gf5ckszr2d-cell/tesis-star-tracker/Inventor/Mecanismo_3GDL/Alineacion_R1_20261113/Captura_real_Inventor_Gimbal_R1.jpg

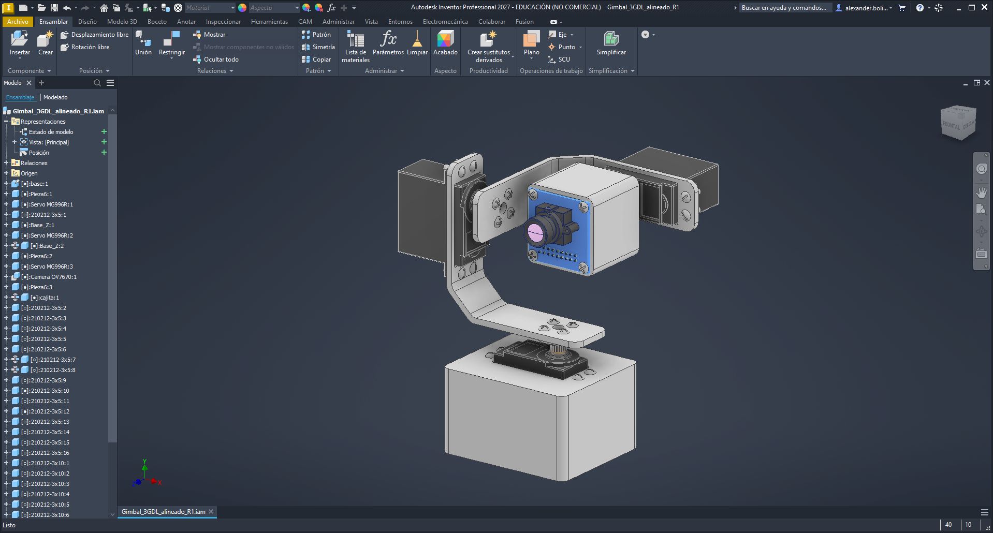
Inventor/Mecanismo_3GDL/Alineacion_R1_20261113/Captura_real_Inventor_Gimbal_R1.jpg
