gf5ckszr2d-cell/tesis-star-tracker/Inventor/Mecanismo_3GDL/Alineacion_R1_20261113/Gimbal_R1_ejes_anotados_generada.png

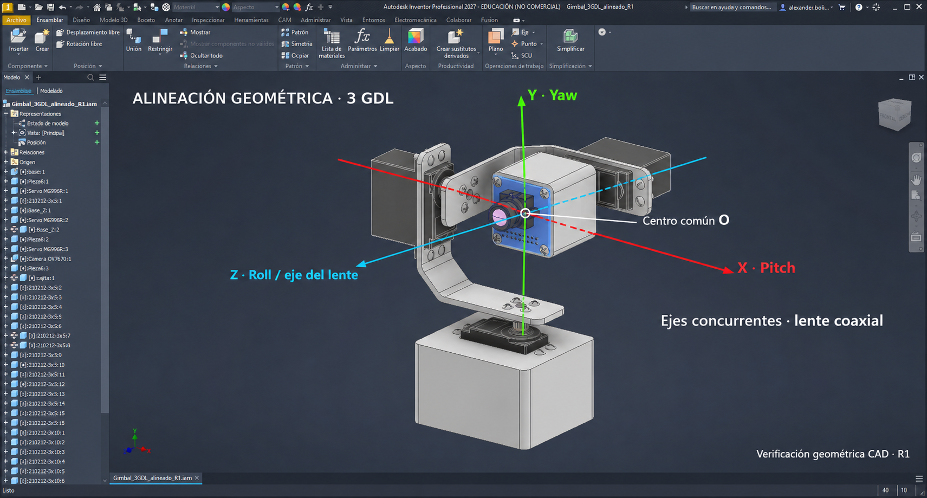
Inventor/Mecanismo_3GDL/Alineacion_R1_20261113/Gimbal_R1_ejes_anotados_generada.png
