gf5ckszr2d-cell/tesis-star-tracker/Inventor/Mecanismo_3GDL/Auditoria_integral_20261113/Choque_carcasa_base_yaw_m60_pitch_m60.jpg

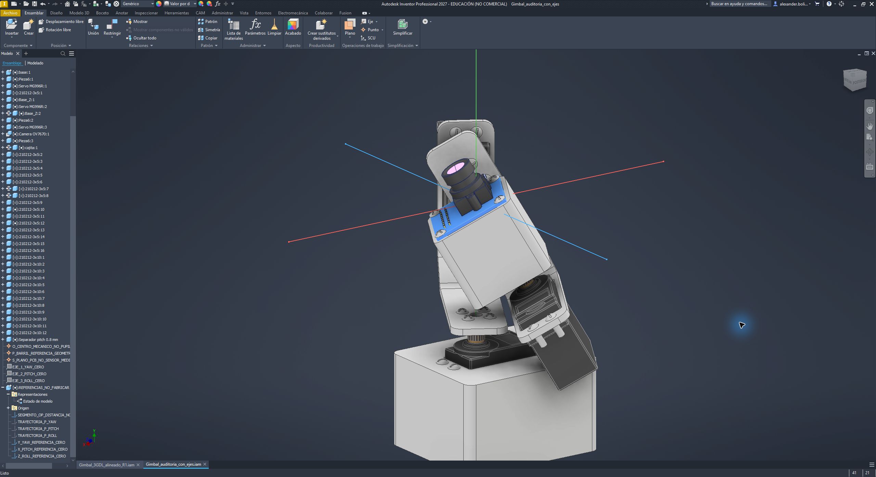
Inventor/Mecanismo_3GDL/Auditoria_integral_20261113/Choque_carcasa_base_yaw_m60_pitch_m60.jpg
