gf5ckszr2d-cell/tesis-star-tracker/Inventor/Mecanismo_3GDL/Auditoria_integral_20261113/Ejes_reales_y_referencias_Inventor.jpg

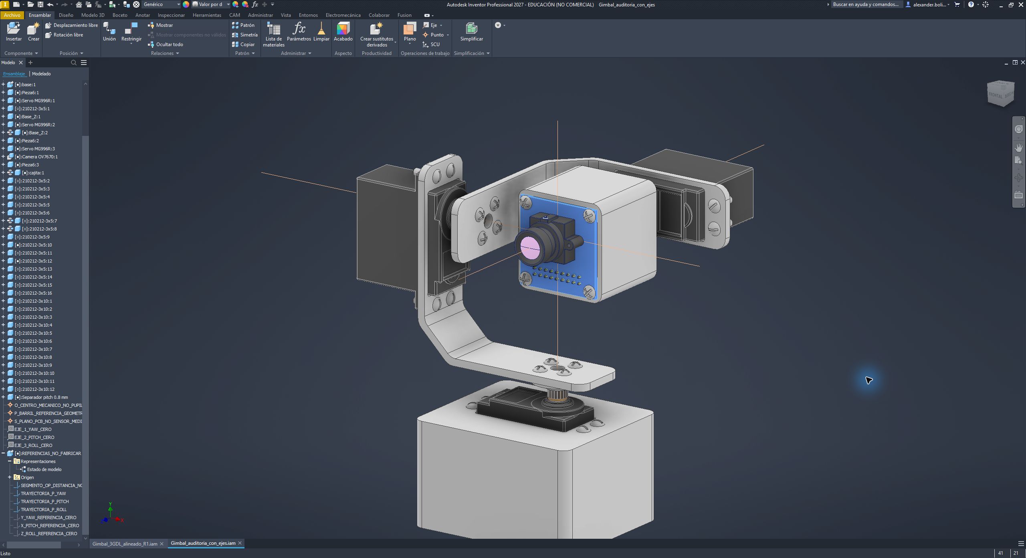
Inventor/Mecanismo_3GDL/Auditoria_integral_20261113/Ejes_reales_y_referencias_Inventor.jpg
