gf5ckszr2d-cell/tesis-star-tracker/Inventor/Mecanismo_3GDL/Auditoria_integral_20261113/Referencia_ejes_usuario.png

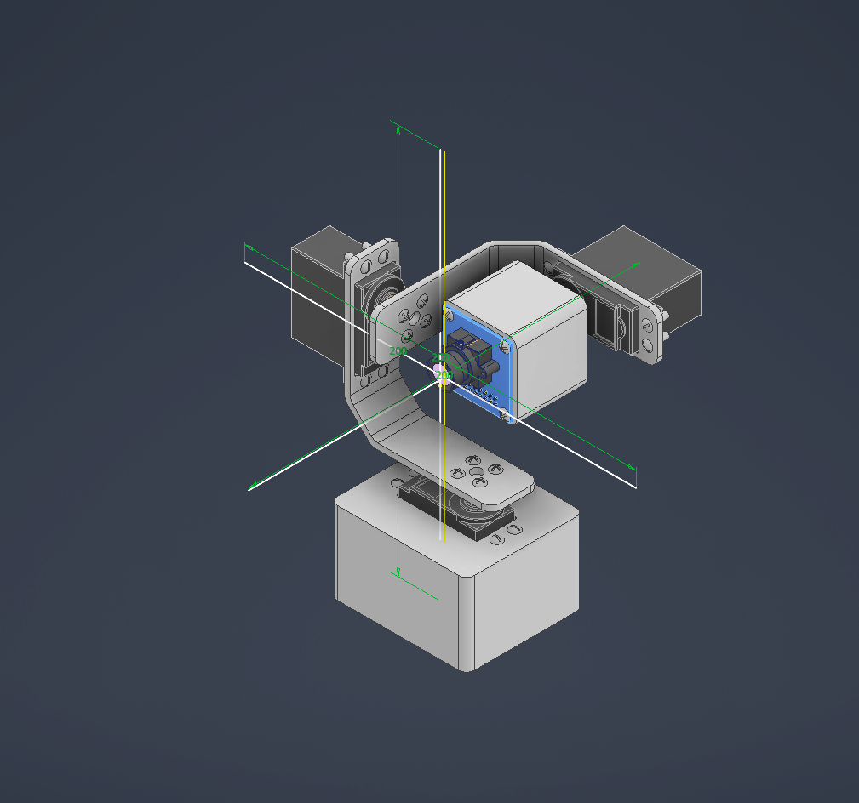
Inventor/Mecanismo_3GDL/Auditoria_integral_20261113/Referencia_ejes_usuario.png
