gf5ckszr2d-cell/tesis-star-tracker/Inventor/Mecanismo_3GDL/Revision_20261113/plano-2.png

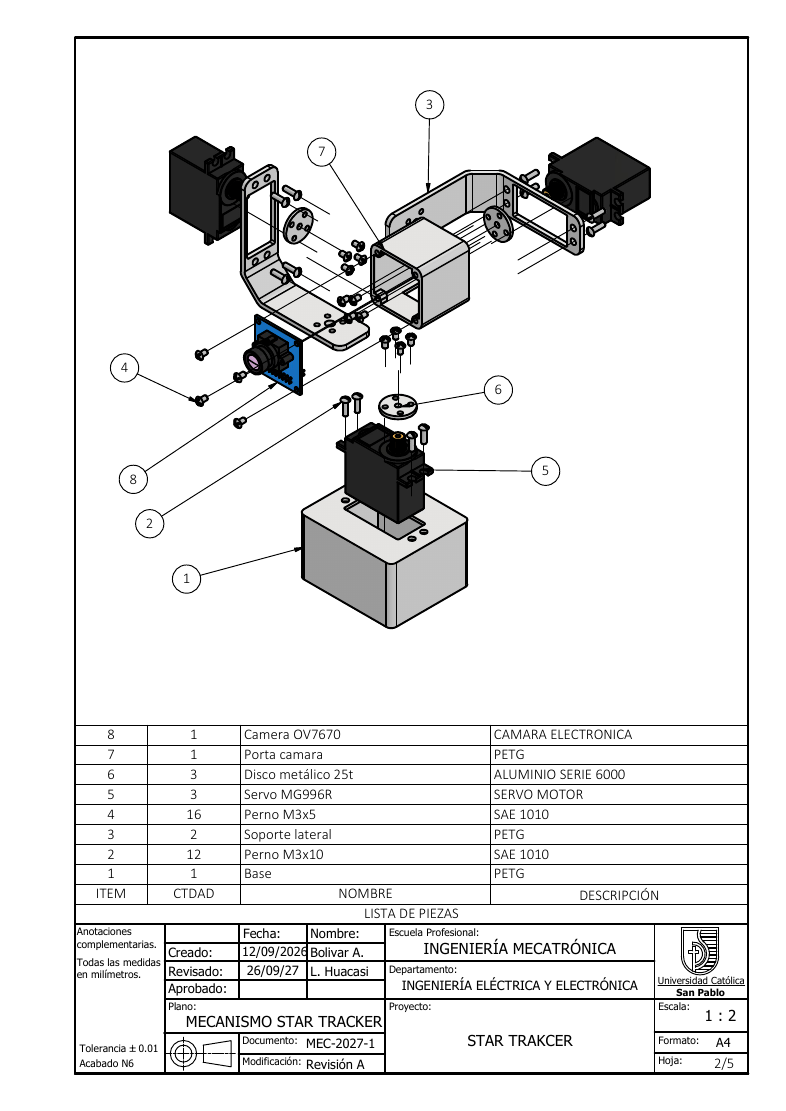
Inventor/Mecanismo_3GDL/Revision_20261113/plano-2.png
