gf5ckszr2d-cell/tesis-star-tracker/recepción de frame/capturas/frame_y.png

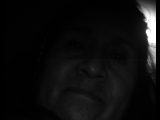
recepción de frame/capturas/frame_y.png
