gf5ckszr2d-cell/tesis-star-tracker/Inventor/Mecanismo_3GDL/Auditoria_integral_20261113/Control/interferencias_movimiento.csv

pose | component_a | component_b | volume_mm3 | class
zero | Servo MG996R:3 | Pieza6:3 | 120.21451917 | servo_head_model_pending
zero | Pieza6:2 | Servo MG996R:2 | 50.3520624212 | servo_head_model_pending
zero | Servo MG996R:1 | Pieza6:1 | 50.3520624212 | servo_head_model_pending
yaw_-60 | Servo MG996R:3 | Pieza6:3 | 120.21451917 | servo_head_model_pending
yaw_-60 | Pieza6:2 | Servo MG996R:2 | 50.3520624211 | servo_head_model_pending
yaw_-60 | Servo MG996R:1 | Pieza6:1 | 50.3520624212 | servo_head_model_pending
yaw_-30 | Servo MG996R:3 | Pieza6:3 | 120.21451917 | servo_head_model_pending
yaw_-30 | Pieza6:2 | Servo MG996R:2 | 50.3520624211 | servo_head_model_pending
yaw_-30 | Servo MG996R:1 | Pieza6:1 | 50.3520624212 | servo_head_model_pending
yaw_-15 | Servo MG996R:3 | Pieza6:3 | 120.21451917 | servo_head_model_pending
yaw_-15 | Pieza6:2 | Servo MG996R:2 | 50.3520624211 | servo_head_model_pending
yaw_-15 | Servo MG996R:1 | Pieza6:1 | 50.3520624212 | servo_head_model_pending
yaw_15 | Servo MG996R:3 | Pieza6:3 | 120.21451917 | servo_head_model_pending
yaw_15 | Pieza6:2 | Servo MG996R:2 | 50.3520624211 | servo_head_model_pending
yaw_15 | Servo MG996R:1 | Pieza6:1 | 50.3520624212 | servo_head_model_pending
yaw_30 | Servo MG996R:3 | Pieza6:3 | 120.21451917 | servo_head_model_pending
yaw_30 | Pieza6:2 | Servo MG996R:2 | 50.3520624211 | servo_head_model_pending
yaw_30 | Servo MG996R:1 | Pieza6:1 | 50.3520624212 | servo_head_model_pending
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
combined_mixed | Servo MG996R:3 | Pieza6:3 | 120.21451918 | servo_head_model_pending
combined_mixed | Pieza6:2 | Servo MG996R:2 | 50.3520624154 | servo_head_model_pending
combined_mixed | Servo MG996R:1 | Pieza6:1 | 50.3520624212 | servo_head_model_pending
