gf5ckszr2d-cell/tesis-star-tracker/(list of files, cad)

Other CAD files:
Inventor/Mecanismo_3GDL/Alineacion_R1_20261113/CAD/Camera OV7670.ipt
Inventor/Mecanismo_3GDL/Alineacion_R1_20261113/CAD/Pieza6.ipt
Inventor/Mecanismo_3GDL/Alineacion_R1_20261113/CAD/Separador_pitch_0p8_R1.ipt
Inventor/Mecanismo_3GDL/Alineacion_R1_20261113/CAD/cajita.ipt
Inventor/Mecanismo_3GDL/Auditoria_integral_20261113/CAD/210212-3x5.ipt
Inventor/Mecanismo_3GDL/Auditoria_integral_20261113/CAD/EjeY.ipt
Inventor/Mecanismo_3GDL/Auditoria_integral_20261113/CAD/Gimbal_auditoria_con_ejes.iam
Inventor/Mecanismo_3GDL/Auditoria_integral_20261113/CAD/Gimbal_barrido_125.iam
Inventor/Mecanismo_3GDL/Auditoria_integral_20261113/CAD/Referencias_cinematicas.ipt
Inventor/Mecanismo_3GDL/Auditoria_integral_20261113/CAD/Servo MG996R.ipt
Inventor/Mecanismo_3GDL/Auditoria_integral_20261113/CAD/base.ipt
Inventor/Mecanismo_3GDL/CAD_portable/210212-3x10.ipt
Inventor/Mecanismo_3GDL/CAD_portable/Servo MG996R.ipt
Inventor/Mecanismo_3GDL/CAD_portable/cajita.ipt
Inventor/Mecanismo_3GDL/Original/Base_Z.ipt
Inventor/Mecanismo_3GDL/Original/Ejez.ipt
Inventor/Mecanismo_3GDL/Original/OldVersions/Base_Z.0002.ipt
Inventor/Mecanismo_3GDL/Original/OldVersions/Ejez.0003.ipt
Inventor/Mecanismo_3GDL/Original/OldVersions/Pieza6.0002.ipt
Inventor/Mecanismo_3GDL/Original/OldVersions/base.0002.ipt
Inventor/Mecanismo_3GDL/Original/OldVersions/cajita.0001.ipt
Inventor/Mecanismo_3GDL/Original/OldVersions/mecanismo compoleto.0001.ipn
Inventor/Mecanismo_3GDL/Original/OldVersions/mecanismo compoleto.0004.iam
Inventor/Mecanismo_3GDL/Original/mecanismo compoleto.iam
Inventor/Mecanismo_3GDL/Original/mecanismo compoleto.ipn
