gf5ckszr2d-cell/tesis-star-tracker/Inventor/Mecanismo_3GDL/Auditoria_integral_20261113/Control/ejes_moviles_verificados.txt

MOVED=False OCC=Servo MG996R:1 DIR=-2.34942862846E-32,-1,1.73472347598E-16 CENTER_MISS_MM=2.0661563443E-11
MOVED=False OCC=Servo MG996R:2 DIR=-1,1.96638228954E-15,-4.25585492773E-16 CENTER_MISS_MM=1.48852415319E-11
MOVED=False OCC=Servo MG996R:3 DIR=1.09786546787E-15,-1.37761517962E-15,-1 CENTER_MISS_MM=1.44500495542E-11
MOVED=True OCC=Servo MG996R:1 DIR=-3.31239360065E-32,-1,1.73472347598E-16 CENTER_MISS_MM=2.06607778479E-11
MOVED=True OCC=Servo MG996R:2 DIR=-0.939692620786,2.10701379323E-15,-0.342020143326 CENTER_MISS_MM=9.0209651284E-12
MOVED=True OCC=Servo MG996R:3 DIR=0.296198132726,0.5,-0.813797681349 CENTER_MISS_MM=1.91322838463E-11
LIVE_AXIS_BINDING_PASS=true
