gf5ckszr2d-cell/tesis-star-tracker/pruebas_arty_z7/captura_ov7670_qvga/pc/requirements-banco-verificadas.txt

pyserial==3.5
Pillow==13.0.0
numpy==2.3.5
