gf5ckszr2d-cell/tesis-star-tracker/pruebas_arty_z7/captura_ov7670_qvga/output/LAP_20261110/DoE_final_plan_tesis_completa_16_v3.pptx

Star Tracker

Planificación del DoE
y del LAP

D1–D5, integración en FPGA
y entrega final de tesis
1–11 DoE 12–16 LAP

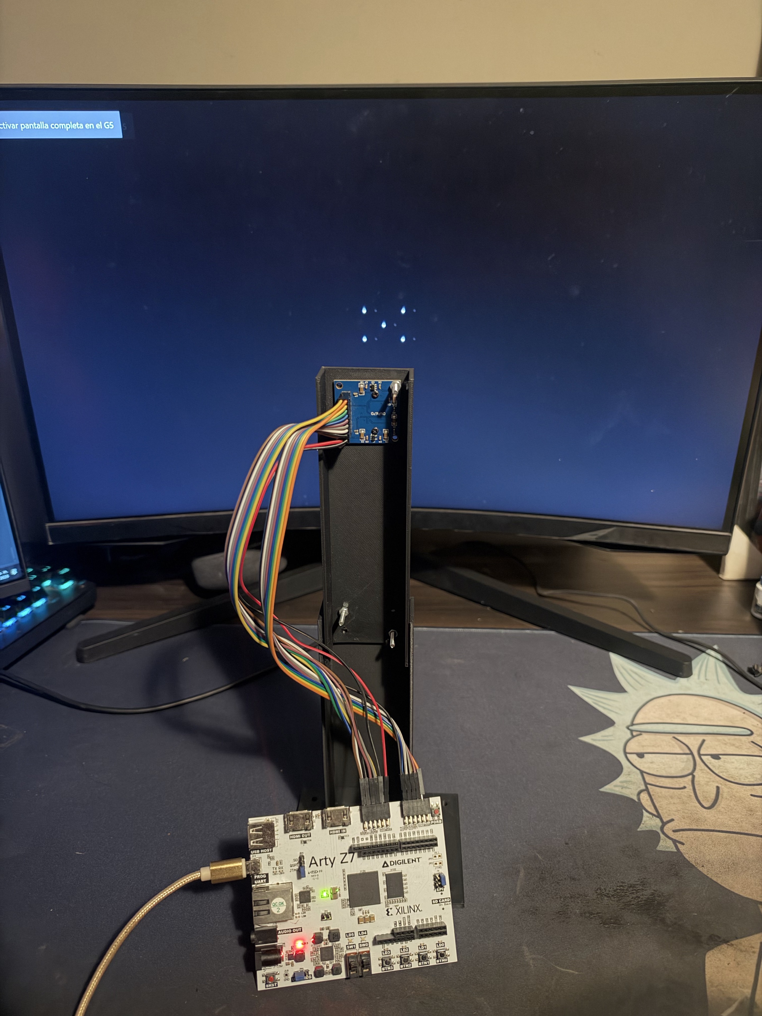
[picture p13: figure]

Alexander Bolívar Huachaca · Plan de tesis · 10 de noviembre de 2026

01

Notes: Esta exposición planifica toda la tesis. El DoE definirá factores, niveles, repeticiones y análisis desde la captura hasta la identificación y la actitud. El LAP establecerá cómo aceptar el sistema completo. La planificación también incluye integración en FPGA, informes y entrega final. Las cantidades son propuestas de ensayo y los límites son metas por comprobar.

Fuentes y alcance:
Alexander Bolívar Huachaca · Plan de tesis · 10 de noviembre de 2026

## Slide 2

DoE · Objetivo y alcance de toda la tesis

Etapa | Qué se investigará | Salida prevista
D1 | Exposición y ganancia | Perfil de captura candidato
D2 | Tamaño y posición de fuente | Centroide y referencia geométrica
D3 | Separación y ruido | Dominio de fuentes distinguibles
D4 | Catálogo e interferencias | Identificadores HIP y rechazos
D5 | Orientación y tiempo | Cuaternión, validez y latencia

Integración prevista: cadena operativa en VHDL/FPGA, LAP y memoria final.
Banco: Arty Z7 + OV7670, YUV422, luminancia QVGA 320 × 240.

Planificación del DoE de tesis. Niveles y cantidades propuestos antes de ejecutar.

02

Notes: El objetivo será caracterizar y ajustar un sistema que capture estrellas, extraiga sus centroides, las identifique en catálogo y estime actitud con una salida válida. D1 a D3 estudiarán imagen, posición y separación. D4 estudiará identificación y D5 actitud y tiempo. Después se integrará la cadena operativa en FPGA y se comprobará con el LAP. El PC preparará escenas y actuará como referencia independiente y registro.

Fuentes y alcance:
Planificación del DoE de tesis. Niveles y cantidades propuestos antes de ejecutar.

## Slide 3

DoE · Flujo y dependencias

D1 · Captura

Perfil de exposición
y ganancia

D2 · Centroide

Referencia geométrica
y tamaño útil

D3 · Separación

Fuentes distinguibles
en campos con ruido

LAP · Sistema

Datos reservados
y criterios congelados

D5 · Actitud

Cuaternión válido
y tiempo de respuesta

D4 · Identificación

Asociaciones HIP
contrastadas con catálogo

Cada etapa entregará entradas verificables a la siguiente. El LAP sustentará las conclusiones de tesis.

Planificación del DoE de tesis. Niveles y cantidades propuestos antes de ejecutar.

03

Notes: D1 fijará una imagen útil para medir en D2. D2 fijará la referencia y el tamaño útil para estudiar separación en D3. D3 definirá qué campos pueden entrar al identificador de D4. D4 entregará correspondencias verificables para estimar actitud en D5. El LAP comprobará la configuración integrada con datos reservados. Un fallo de imagen devolverá a D1, de geometría o tamaño a D2, de separación a D3, de identificación a D4 y de estimación a D5.

Fuentes y alcance:
Planificación del DoE de tesis. Niveles y cantidades propuestos antes de ejecutar.

## Slide 4

DoE · Variables, controles y referencia

Condiciones del banco

Distancia: 250 mm
Montaje, pose y foco fijos
Brillo OSD 0 y HDR desactivado
Pantalla 2560×1440, escalado registrado
Perfil D1 fijo para D2–D5
Una captura por condición y bloque

Referencia geométrica prevista

Escalado real del patrón a pantalla
Mapa pantalla–cámara con puntos
de ajuste y puntos reservados
Ángulo: θ = arctan(Δx / distancia)
Focal efectiva e intrínsecos calibrados
Distorsión e incertidumbre registradas

Centroide: error radial respecto a una referencia independiente.
Actitud: error angular respecto a q_ref con convenciones y unidades registradas.

Planificación del DoE de tesis. Niveles y cantidades propuestos antes de ejecutar.

04

Notes: Las unidades de diseño serán píxeles del generador y las medidas serán píxeles de cámara o grados, según la etapa. Se registrará el escalado real de la ventana. La geometría relacionará pantalla, cámara y catálogo. Antes de comparar centroides se obtendrá un mapa local y antes de verificar actitud se calibrarán intrínsecos y distorsión, indicando marcos, focal efectiva e incertidumbre. Las cinco repeticiones por condición se distribuirán en cinco bloques con orden aleatorio.

Fuentes y alcance:
Planificación del DoE de tesis. Niveles y cantidades propuestos antes de ejecutar.
El desplazamiento Δx se expresará en longitud física de pantalla tras verificar su paso y escalado. La calibración geométrica inicial usará nueve posiciones por tres capturas, seis posiciones para ajustar y tres reservadas. El mapa afín local no bastará por sí solo para demostrar exactitud angular del sistema. La calibración intrínseca para D5 incluirá su propio registro y verificación antes de congelar la configuración. El centroide de intensidad se definirá sobre Y menos el fondo con una política de umbral fija. Las repeticiones no equivalen a escenas independientes.

## Slide 5

D1 · Exposición y ganancia

Condición | Exposición | Ganancia | Repeticiones | Capturas
C01 | 96 | 0 | 5 | 5
C02 | 96 | 16 | 5 | 5
C03 | 192 | 0 | 5 | 5
C04 | 192 | 16 | 5 | 5
C05 | 384 | 0 | 5 | 5
C06 | 384 | 16 | 5 | 5

30 capturas. Exposición y ganancia: códigos de registro.
Respuestas: contraste, ruido y saturación.

Planificación del DoE de tesis. Niveles y cantidades propuestos antes de ejecutar.

05

Notes: D1 planificará un factorial de tres exposiciones y dos ganancias. Cada una de las seis condiciones tendrá cinco repeticiones, una por bloque. El patrón inicial será un campo fijo de cinco fuentes. Se registrarán integridad, contraste, ruido de fondo, picos y saturación. Los códigos de registro se comprobarán en la preparación y se fijarán antes de ejecutar la matriz. Se elegirá un perfil que permita medir las etapas siguientes.

Fuentes y alcance:
Planificación del DoE de tesis. Niveles y cantidades propuestos antes de ejecutar.
Códigos del sensor, no milisegundos ni decibelios. Patrón nominal inicial: cinco discos de ocho píxeles de diseño, RGB 255, sin ruido añadido. Se verificará que queden en el encuadre. Los parámetros son propuestas que se congelarán tras el piloto.

## Slide 6

D2 · Tamaño y centroide

Condición | Diámetro de diseño | Posición | Repeticiones | Capturas
C01 | 4 px | Centro | 5 | 5
C02 | 4 px | +50 px | 5 | 5
C03 | 8 px | Centro | 5 | 5
C04 | 8 px | +50 px | 5 | 5
C05 | 12 px | Centro | 5 | 5
C06 | 12 px | +50 px | 5 | 5

3 × 2 × 5 = 30 capturas. Perfil D1 fijo y referencia geométrica.

Planificación del DoE de tesis. Niveles y cantidades propuestos antes de ejecutar.

06

Notes: D2 combinará tres diámetros del patrón y dos posiciones con cinco repeticiones por condición. Se usará una fuente aislada y el perfil seleccionado en D1. Se registrarán FWHM, posición, error radial y dispersión. Las coordenadas de referencia procederán de la geometría calibrada y del escalado real. El análisis en PC caracterizará la escena y contrastará el resultado, mientras que el LAP verificará el centroide operativo de FPGA.

Fuentes y alcance:
Planificación del DoE de tesis. Niveles y cantidades propuestos antes de ejecutar.
FWHM y centroides se expresarán en píxeles de cámara, mientras que el diámetro de este factor está en píxeles de diseño. Error radial e_i = distancia entre centroide y referencia. RMS radial = raíz del promedio de e_i². Se informarán sesgo y dispersión por separado, con incertidumbre de referencia. La posición desplazada deberá seguir dentro del encuadre. Se reservarán diez capturas auxiliares para confirmar el perfil de D2.

## Slide 7

D3 · Separación y ruido

Condición | Separación de diseño | Ruido σRGB | Repeticiones | Capturas
C01 | 8 px | 0 | 5 | 5
C02 | 8 px | 8 | 5 | 5
C03 | 16 px | 0 | 5 | 5
C04 | 16 px | 8 | 5 | 5
C05 | 24 px | 0 | 5 | 5
C06 | 24 px | 8 | 5 | 5

3 × 2 × 5 = 30 capturas. Se contarán fusiones, omisiones y falsas.

Planificación del DoE de tesis. Niveles y cantidades propuestos antes de ejecutar.

07

Notes: D3 cruzará tres separaciones y dos niveles de ruido del generador. Cada cuadro tendrá cinco fuentes y cada condición tendrá cinco repeticiones. El perfil y el diámetro quedarán fijos después de D2. Se medirán detecciones correctas, fusiones, omisiones y falsas por cuadro y por fuente. La distancia mínima entre centros se registrará en píxeles de diseño y también se medirá en cámara. El dominio útil se transmitirá a D4.

Fuentes y alcance:
Planificación del DoE de tesis. Niveles y cantidades propuestos antes de ejecutar.
El ruido se añadirá con semilla registrada en códigos RGB del patrón, sin asumir equivalencia a DN de luminancia de cámara. Se medirá también el ruido capturado. El diámetro nominal inicial será cuatro píxeles de diseño, sujeto a observabilidad en D2. La matriz se congelará antes de ejecutarse, verificando que las fuentes del patrón no se solapen.

## Slide 8

D4 · Catálogo e identificación estelar

Condición | Sector | Fuentes HIP | Fuente falsa | Capturas
C01 | H01 | 8 | 0 | 5
C02 | H01 | 8 | 1 | 5
C03 | H02 | 8 | 0 | 5
C04 | H02 | 8 | 1 | 5
C05 | H03 | 8 | 0 | 5
C06 | H03 | 8 | 1 | 5

3 sectores × 2 condiciones × 5 = 30 capturas. Geometría útil de D3.

Planificación del DoE de tesis. Niveles y cantidades propuestos antes de ejecutar.

08

Notes: D4 planificará tres sectores de catálogo y dos condiciones: nominal y una fuente falsa añadida. Cada sector contendrá ocho fuentes reales identificadas en HIP, con geometría y catálogo versionados. Habrá cinco repeticiones por condición. H01, H02 y H03 son etiquetas de sectores por seleccionar, no identificadores HIP inventados. Se registrarán asociaciones correctas, falsas y rechazos. El catálogo de evaluación será independiente de las salidas del identificador.

Fuentes y alcance:
Planificación del DoE de tesis. Niveles y cantidades propuestos antes de ejecutar.
Se seleccionarán sectores con suficientes estrellas dentro del campo calibrado y separaciones resolubles según D3. La fuente falsa se ubicará de manera reproducible sin atribuirle HIP. Se guardarán catálogo, época, coordenadas, proyección y semilla. Precisión = asociaciones correctas / asociaciones emitidas. Los rechazos y la tasa de solución completa se informarán aparte. Los casos de menos de cinco coincidencias y otras entradas adversas también tendrán pruebas digitales negativas.

## Slide 9

D5 · Actitud y tiempo de respuesta

Condición | Eje | Giro virtual | Repeticiones | Capturas
C01 | X | -5° | 5 | 5
C02 | X | +5° | 5 | 5
C03 | Y | -5° | 5 | 5
C04 | Y | +5° | 5 | 5
C05 | Z | -5° | 5 | 5
C06 | Z | +5° | 5 | 5

3 ejes × 2 giros × 5 = 30 capturas. Error angular, éxito y latencia.

Planificación del DoE de tesis. Niveles y cantidades propuestos antes de ejecutar.

09

Notes: D5 combinará tres ejes y dos giros virtuales de referencia, con cinco repeticiones. Se renderizarán campos de catálogo a partir de orientaciones conocidas y una geometría de cámara calibrada. Se comprobará primero que cada orientación conserve suficientes fuentes visibles. El sistema entregará cuaternión y validez. Se comparará con q_ref y se medirá el tiempo desde la solicitud aceptada de captura hasta la salida estable.

Fuentes y alcance:
Planificación del DoE de tesis. Niveles y cantidades propuestos antes de ejecutar.
Los giros ±5° son niveles propuestos, no giros físicos medidos de la cámara. q_ref se generará con una implementación independiente y convenciones de marcos y orden de cuaternión documentados. Para cuaterniones unitarios, error angular = 2 acos(min(1, abs(dot(q, q_ref)))). Se informará el error en grados, RMS y máximo. No se usará el estimador sometido a prueba para producir su propia referencia. La transferencia UART al PC quedará fuera de la latencia operativa. Extensión deseable RS-13: tasas 0, 0,1, 0,25, 0,5 y 1°/s por tres ejes y cinco repeticiones, 75 cuadros adicionales, con movimiento durante exposición. No integra el conteo base.

## Slide 10

DoE · Cantidades y procedimiento previsto

Bloque del plan | Capturas | Uso previsto
D1–D3 | 90 | Tres matrices de 30
D4 | 30 | Catálogo e interferencias
D5 | 30 | Actitud estática y tiempo
Auxiliares | 57 | Piloto, niveles Y, geometría y confirmación
Subtotal DoE | 207 | Matrices y preparación
LAP reservado | 200 | 100 centroides + 100 sistema
Total base | 407 | DoE y LAP
Dinámica opcional | 75 | 5 tasas × 3 ejes × 5
Total con extensión | 482 | Base y dinámica opcional

Captura por bloque y condición. RAW/PNG, configuración y logs con ID único.

Planificación del DoE de tesis. Niveles y cantidades propuestos antes de ejecutar.

10

Notes: El plan base reservará ciento cincuenta capturas para las cinco matrices, treinta por etapa. Se añadirán cincuenta y siete auxiliares y doscientas nuevas para LAP. El total base será cuatrocientas siete. La extensión dinámica, si se incluye, agregará setenta y cinco. Se aleatorizará el orden dentro de cada bloque y se conservarán intentos fallidos. Cada registro identificará patrón, configuración, versiones, unidades, tiempo y archivos originales.

Fuentes y alcance:
Planificación del DoE de tesis. Niveles y cantidades propuestos antes de ejecutar.
Auxiliares: cinco piloto, quince de niveles digitales (RGB 0, 64, 128, 192 y 255 con tres repeticiones), veintisiete geométricas (nueve posiciones por tres) y diez de confirmación D2. Los extremos RGB son referencias digitales de pantalla, no luminancia absoluta. El conteo base cubre estos cuadros especificados. Otros registros que requiera la calibración óptica y los reintentos se presupuestarán y registrarán aparte, sin presentarlos como ya incluidos. Las cinco repeticiones son una elección exploratoria, no un cálculo de potencia ni una cantidad exigida por una norma. El piloto permitirá revisar la variabilidad antes de congelar el plan.

## Slide 11

DoE · Análisis, integración y cierre de tesis

Etapa | Análisis previsto | Entregable para integración
D1 | Contraste, ruido, saturación e interacción | Perfil de captura
D2 | FWHM, sesgo y RMS del centroide | Geometría y tamaño útil
D3 | Correctas, fusiones, omisiones y falsas | Dominio de separación
D4 | Precisión de asociaciones y rechazos | Catálogo y parámetros del identificador
D5 | RMS angular, éxito y latencia | Estimador y condiciones de operación

Integración VHDL, XSim, síntesis, implementación y prueba física del bitstream.
Entrega: memoria de tesis, discusión, conclusiones, fuentes, datos y sustentación.

Planificación del DoE de tesis. Niveles y cantidades propuestos antes de ejecutar.

11

Notes: D1 a D3 analizarán efectos de factores e interacciones, con bloqueo temporal y métricas por condición. D4 evaluará precisión de asociaciones y rechazos. D5 evaluará error angular, soluciones correctas y latencia. Después se integrará la cadena operativa, se simulará en Vivado/XSim, se sintetizará y se revisarán recursos y timing después de implementación. El bitstream final se comprobará en hardware mediante el LAP. La tesis cerrará con resultados, incertidumbres, limitaciones y archivos reproducibles.

Fuentes y alcance:
Planificación del DoE de tesis. Niveles y cantidades propuestos antes de ejecutar.
La simulación funcional, la síntesis, el timing y la aceptación física serán evidencias distintas. El análisis de tasas indicará numeradores y denominadores e intervalos de incertidumbre. No se atribuirá generalización a todo el cielo con tres sectores. Antes del LAP se congelarán catálogo, calibración, umbrales, versiones del RTL y firmware, bitstream y reglas de decisión. La documentación acompañará cada fase y sustentará la comparación con los objetivos de tesis.

## Slide 12

LAP · Alcance completo y fundamento

Objeto de aceptación

Cadena completa operativa en FPGA
Captura y rechazo de datos inválidos
Centroide e identificación HIP
Actitud, validez y latencia
Datos nuevos reservados
Configuración y criterios congelados
Referencia independiente

Referencias del método

Schulz et al. (2021)
Universal Verification Platform and Star Simulator for Fast Star Tracker Design
Sun, Xing y You (2013)
Optical System Error Analysis and Calibration Method of High-Accuracy Star Trackers
Lou et al. (2026)
A Multi-Strategy Adaptive Error Modeling and Compensation Method for Star Point Centroid Extraction

Planificación del LAP del sistema completo. Metas por fijar antes de la aceptación.

12

Notes: El LAP será el protocolo de aceptación de laboratorio para la cadena completa: adquisición, detección, centroides, identificación, actitud y tiempo de respuesta en FPGA. Usará una configuración congelada y datos reservados. Las referencias apoyan la simulación de estrellas, la calibración y el análisis de centroides. Los límites numéricos procederán de los requisitos del proyecto, con metas pendientes de fijar, y no se atribuirán a los artículos como si fueran una norma de aceptación.

Fuentes y alcance:
Planificación del LAP del sistema completo. Metas por fijar antes de la aceptación.

Schulz et al. (2021). Universal Verification Platform and Star Simulator for Fast Star Tracker Design. https://doi.org/10.3390/s21030907
Sun, Xing y You (2013). Optical System Error Analysis and Calibration Method of High-Accuracy Star Trackers. https://doi.org/10.3390/s130404598
Lou et al. (2026). A Multi-Strategy Adaptive Error Modeling and Compensation Method for Star Point Centroid Extraction. https://doi.org/10.5194/isprs-archives-XLIX-B1-2026-279-2026
Requisitos del proyecto: Documentacion/control/requisitos.csv. Los criterios marcados por revisar en ese registro conservarán su carácter de metas propuestas hasta su cierre previo al LAP.

## Slide 13

LAP · Requisitos y métodos de verificación

Ensayo | Requisitos del proyecto | Método previsto
L01 · Captura | Captura íntegra y rechazo | Dimensiones, checksum y fallos
L02 · Centroide | RS-04 / RS-05: fuentes y error | Salida FPGA frente a referencia
L03 · Identificación | RS-06 / RS-14: identificación | Contraste con catálogo
L04 · Actitud | RS-07, RS-08, RS-10, RS-15 | Cuaternión, error, éxito y fallos
L05 · Integración | RS-09 / RS-11 / RD-03 | Tiempo, recursos y timing

RB-03/RB-05: referencia comprobada y datos reservados.
RD-01/RD-02: versiones, procedimiento y evidencias reproducibles.

Planificación del LAP del sistema completo. Metas por fijar antes de la aceptación.

13

Notes: Se agruparán los requisitos en cinco ensayos de la cadena completa. L01 comprobará el contrato de captura y el rechazo de datos erróneos. L02 verificará detección, centroides y capacidad. L03 contrastará las asociaciones HIP y las coincidencias mínimas. L04 comprobará actitud y validez contra una referencia independiente. L05 medirá tiempo y revisará la implementación operativa en FPGA. La referencia PC no sustituirá la salida real que se somete a aceptación.

Fuentes y alcance:
Planificación del LAP del sistema completo. Metas por fijar antes de la aceptación.
Los identificadores se refieren a las filas RS04, RS05, etc., del CSV del proyecto. La agrupación L01–L05 organiza los métodos previstos y no afirma que los requisitos estén ya evaluados. El plano de depuración para observar centroides, HIP y cuaternión se definirá separado del UART de imágenes, conservando ese contrato.

## Slide 14

LAP · Metas y reglas de aceptación

Ensayo | Criterio propuesto para fijar antes del LAP
L01 · Captura | 320×240, 76 800 Y, checksum correcto. Datos corruptos: rechazo.
L02 · Centroide | RMS radial ≤0,2 px. Hasta 64 fuentes y desbordamiento explícito.
L03 · Identificación | ≥99% de asociaciones emitidas correctas. ≥5 coincidencias únicas.
L04 · Actitud | RMS angular ≤0,1°. Éxito ≥90%. RMS numérico ≤0,005°.
L05 · Integración | Latencia ≤0,1 s. Sin sobreutilización. Timing satisfecho.

Metas del proyecto pendientes de cierre. Se conservarán errores, rechazos y no conformidades.

Planificación del LAP del sistema completo. Metas por fijar antes de la aceptación.

14

Notes: Estas son metas de los requisitos que se fijarán antes de ejecutar. El error de centroide se medirá en salida FPGA frente a una referencia con incertidumbre caracterizada. Las asociaciones correctas se dividirán entre las emitidas y los rechazos se informarán aparte. La actitud exigirá precisión y proporción de soluciones correctas. La latencia terminará cuando cuaternión y validez estén estables. El fallo rápido no contará como solución exitosa.

Fuentes y alcance:
Planificación del LAP del sistema completo. Metas por fijar antes de la aceptación.
El límite de 0,005° verifica el estimador frente a precisión alta con los mismos vectores y correspondencias correctas, separado del ensayo óptico completo. RMS de referencia geométrica reservada objetivo ≤0,2 px (RB-03), sin confundirlo con error absoluto del centroide. Se propagará la incertidumbre de referencia y se acordará una regla para resultados cercanos al límite. Éxito = soluciones dentro de la tolerancia fijada / todos los intentos programados del ensayo completo. Se usarán al menos cinco coincidencias únicas y geométricamente compatibles; menos de cinco, desbordamiento o rechazo darán salida inválida. La latencia incluirá captura, espera y procesamiento, y excluirá volcado diagnóstico UART al PC. Los informes de setup/hold, restricciones y CDC acompañarán la implementación, junto con LUT/FF/BRAM/DSP y frecuencia.

## Slide 15

LAP · Muestra reservada y evidencias esperadas

Conjunto reservado | Diseño de la muestra | Capturas
Centroide FPGA | 10 posiciones nuevas × 10 repeticiones | 100
Sistema completo | 10 escenas nuevas × 10 repeticiones | 100
Total físico LAP | Datos ajenos al ajuste de parámetros | 200

Pruebas digitales: imagen corrupta, <5 coincidencias, desbordamiento y geometría degenerada.
Evidencias: RAW/PNG, salidas FPGA, catálogo/q_ref, CSV, logs XSim y reportes de Vivado.
Paquete final: versiones, bitstream, criterios, decisiones y registro de desviaciones.

Planificación del LAP del sistema completo. Metas por fijar antes de la aceptación.

15

Notes: Se planificarán doscientos cuadros nuevos reservados. Cien corresponderán a diez posiciones de fuente aislada con diez repeticiones para el centroide. Otros cien corresponderán a diez escenas reservadas con diez repeticiones para el sistema completo. Se seleccionarán antes del LAP con geometría, sectores y perturbaciones definidos, sin utilizarlos para ajustar. Una captura podrá servir a varios requisitos sin volver a contarse. Se añadirán pruebas digitales negativas y evidencias de implementación.

Fuentes y alcance:
Planificación del LAP del sistema completo. Metas por fijar antes de la aceptación.
La selección de las diez escenas deberá cubrir posiciones y orientaciones reservadas, casos nominales y perturbados, con un inventario congelado de fuentes e identificadores. Cada salida tendrá la marca de validez. Se observarán centroides, HIP y cuaternión mediante un mecanismo de diagnóstico separado, sin ampliar el UART de imágenes para centroides. La latencia usará eventos del sistema. Se preservarán originales, manifiestos y hashes de catálogo, generador, calibración, RTL, firmware y bitstream. Los casos digitales no añaden capturas físicas. Cien cuadros por conjunto es una propuesta inicial de planificación, no una prueba universal de significancia estadística.

## Slide 16

LAP · Decisión y entrega final de tesis

Decisión o cierre | Tratamiento previsto
Conforme | Criterios satisfechos y evidencia identificada.
No conforme | Registrar fallo, magnitud, causa y corrección.
No evaluable | Completar referencia o evidencia y volver a comprobar.
Nueva versión | Repetir ensayos afectados e integración con datos reservados.
Entrega de tesis | Memoria, anexos, fuentes, datos y sustentación.

El cierre documentará los límites reales del sistema y el estado de cada requisito.

Planificación del LAP del sistema completo. Metas por fijar antes de la aceptación.

16

Notes: El cierre de tesis dependerá de una matriz trazable desde cada requisito hasta el método, criterio, evidencia y decisión. Si cumple se registrará conformidad. Si incumple se conservará la desviación con su magnitud y alcance. Si falta referencia o evidencia se marcará no evaluable. Toda corrección cambiará de versión y repetirá las verificaciones afectadas. La entrega final incluirá la memoria con metodología, resultados, incertidumbre, limitaciones y conclusiones, además de archivos y sustentación.

Fuentes y alcance:
Planificación del LAP del sistema completo. Metas por fijar antes de la aceptación.
El cierre no convertirá una no conformidad en éxito por omisión. Se conservará toda evidencia y se delimitará el alcance que sostienen los ensayos. Alexander fijará y registrará el montaje y condiciones. La automatización ejecutará el plan y generará registros cuando se autorice la fase experimental. El revisor contrastará requisitos, evidencia y regla aplicada. No se ejecutará nuevo hardware como parte de esta edición documental.
