gf5ckszr2d-cell/tesis-star-tracker/pruebas_arty_z7/captura_ov7670_qvga/output/LAP_20261110/DoE_final_planificacion_16_v2.pptx

Star Tracker

Planificación del DoE
y del LAP


1–11 · Diseño de experimentos
12–16 · Aceptación de laboratorio

Alexander Bolívar Huachaca · Plan de ensayo · 10 de noviembre de 2026

01

Notes: Esta exposición presenta la planificación del ensayo. La primera parte define qué investigará el DoE, qué variables se modificarán y cuántas capturas se programarán. La segunda parte define el LAP: qué requisitos se comprobarán, con qué métodos y qué criterios permitirán emitir una decisión. Los números que presentaré son cantidades y límites del plan, no resultados de validación.

Fuentes y alcance:
Alexander Bolívar Huachaca · Plan de ensayo · 10 de noviembre de 2026

## Slide 2

DoE · Objetivo y alcance

Etapa | Qué se investigará | Salida prevista
D1 · Captura | Exposición y ganancia | Perfil de adquisición candidato
D2 · Fuente aislada | Diámetro, posición y geometría | Tamaño y centroide caracterizados
D3 · Campo | Separación y ruido | Dominio de fuentes distinguibles

Sistema de ensayo: Arty Z7 + OV7670, YUV422 y captura Y8 de 320 × 240.

D4 y D5 quedan como continuación del desarrollo.

Planificación del DoE. Factores, niveles y cantidades propuestos para el ensayo.

02

Notes: El DoE investigará cómo influyen la exposición y la ganancia sobre la imagen, cómo cambian el tamaño de fuente y el centroide con la geometría, y cómo afectan la separación y el ruido al reconocimiento de fuentes distintas. El alcance experimental se limita a D1, D2 y D3, sobre luminancia QVGA. D4 y D5 serán etapas posteriores de identificación y actitud y no tendrán criterios de aceptación en este plan.

Fuentes y alcance:
Planificación del DoE. Factores, niveles y cantidades propuestos para el ensayo.

## Slide 3

DoE · Flujo y dependencias

D1 · Captura

Se ajustarán exposición
y ganancia para obtener
una imagen útil.

D2 · Tamaño y centroide

Con perfil fijo se medirán
tamaño, FWHM y
posición de cada fuente.

D3 · Separación y ruido

Con perfil y tamaño fijos
se variarán separación
y ruido del patrón.

DoE: elegir parámetros candidatos. LAP: comprobarlos con capturas nuevas y criterios fijos.

Planificación del DoE. Factores, niveles y cantidades propuestos para el ensayo.

03

Notes: D1 deberá proporcionar un perfil estable de captura antes de medir el tamaño y la posición en D2. D2 deberá permitir fijar el tamaño de fuente y la referencia geométrica antes de estudiar separación en D3. Si falla la imagen se volverá a D1. Si el problema corresponde al tamaño o al umbral, se iterará D2. Los parámetros candidatos del DoE se congelarán antes de usar capturas nuevas en el LAP.

Fuentes y alcance:
Planificación del DoE. Factores, niveles y cantidades propuestos para el ensayo.

## Slide 4

DoE · Variables y condiciones del banco

Etapa | Factores manipulados | Respuestas a registrar
D1 | Exposición y ganancia | Contraste, picos Y y fuentes visibles
D2 | Diámetro y posición | FWHM, centroide, RMS local y dispersión
D3 | Separación y σRGB | Correctas, fusiones, omisiones y falsas

Controles: distancia 250 mm, pose y foco fijos, brillo OSD 0, HDR desactivado.
QVGA 320 × 240; registrar ventana, escalado y versión del generador.
Unidad experimental: un cuadro por condición y bloque de repetición.

Planificación del DoE. Factores, niveles y cantidades propuestos para el ensayo.

04

Notes: Se distinguirán factores manipulados, respuestas medidas y variables de control. Los factores son exposición y ganancia en D1, diámetro y posición en D2, separación y ruido en D3. Se mantendrán fijos el montaje, la distancia, el foco, el formato y las condiciones de pantalla. El ruido de D3 se especificará en códigos RGB del generador y se registrará también su efecto sobre el fondo capturado.

Fuentes y alcance:
Planificación del DoE. Factores, niveles y cantidades propuestos para el ensayo.

## Slide 5

D1 · Factores, niveles y repeticiones

Condición | Exposición¹ | Ganancia¹ | Repeticiones | Capturas
C01 | 96 | 0 | 5 | 5
C02 | 96 | 16 | 5 | 5
C03 | 192 | 0 | 5 | 5
C04 | 192 | 16 | 5 | 5
C05 | 384 | 0 | 5 | 5
C06 | 384 | 16 | 5 | 5

3 × 2 condiciones × 5 repeticiones = 30 capturas planificadas.

Planificación del DoE. Factores, niveles y cantidades propuestos para el ensayo.

05

Notes: D1 tendrá un diseño factorial completo de tres niveles de exposición por dos de ganancia. Cada condición se capturará cinco veces, distribuidas en cinco bloques. Cada bloque incluirá una captura por condición en orden aleatorio. Los códigos iniciales deberán verificarse en la preparación y se fijarán antes de comenzar la matriz. El patrón será un campo constante de cinco fuentes sobre fondo negro.

Fuentes y alcance:
Planificación del DoE. Factores, niveles y cantidades propuestos para el ensayo.
¹ Son códigos de registro del sensor, no milisegundos ni decibelios. Patrón inicial: cinco discos de 8 px de diseño, RGB 255, sin ruido añadido. Cinco repeticiones es una decisión exploratoria del plan, no una exigencia universal del DoE.

## Slide 6

D2 · Factores, niveles y repeticiones

Condición | Diámetro de diseño | Posición | Repeticiones | Capturas
C01 | 4 px | Centro | 5 | 5
C02 | 4 px | +50 px | 5 | 5
C03 | 8 px | Centro | 5 | 5
C04 | 8 px | +50 px | 5 | 5
C05 | 12 px | Centro | 5 | 5
C06 | 12 px | +50 px | 5 | 5

3 × 2 condiciones × 5 repeticiones = 30 capturas. Perfil D1 fijo.

Planificación del DoE. Factores, niveles y cantidades propuestos para el ensayo.

06

Notes: D2 tendrá tres diámetros de diseño y dos posiciones, con cinco repeticiones por condición. Se mantendrá fijo el perfil de exposición y ganancia elegido mediante D1. Los tamaños se expresarán en píxeles del patrón, mientras que el FWHM y los centroides se medirán en píxeles de cámara. La posición desplazada estará cincuenta píxeles de diseño a la derecha del centro y deberá quedar dentro del encuadre.

Fuentes y alcance:
Planificación del DoE. Factores, niveles y cantidades propuestos para el ensayo.

## Slide 7

D2 · Referencia geométrica y medición

Geometría que se establecerá

Distancia D = 250 mm
Paso de pantalla p = 0,2331 mm/px
sx = ancho de ventana·DPR / 2560
sy = alto de ventana·DPR / 1440
θx = arctan(p·Δu_pantalla / D)
c_ref = A · [u, v, 1]ᵀ

Mediciones previstas

x_c = Σ(x·Y) / ΣY
y_c = Σ(y·Y) / ΣY
e_r = distancia(c, c_ref)
RMS local = √promedio(e_r²)
σ_r = √(σ_x² + σ_y²)
FWHM X/Y para caracterizar el foco

Preparación geométrica: 9 posiciones × 3 capturas = 27, con 6 posiciones de ajuste y 3 reservadas.

Planificación del DoE. Factores, niveles y cantidades propuestos para el ensayo.

07

Notes: Antes de comparar centroides se establecerá una correspondencia entre pantalla y cámara. Se registrará el escalado real de la ventana y se usarán nueve posiciones de fuente, con tres capturas por posición. Se ajustará un mapa con seis posiciones y se reservarán tres para comprobarlo. El paso de pantalla y la distancia relacionarán desplazamiento y ángulo. La focal o escala equivalente se obtendrá del ajuste, sin asignarle de antemano un valor medido.

Fuentes y alcance:
Planificación del DoE. Factores, niveles y cantidades propuestos para el ensayo.
Paso p tomado del área activa horizontal de 596,736 mm y 2560 píxeles. El foco se mantendrá fijo después de su ajuste al montaje. El mapa proporcionará una referencia local; no se presupone calibración óptica absoluta.

## Slide 8

D3 · Factores, niveles y repeticiones

Condición | Separación de diseño | σRGB de entrada | Repeticiones | Capturas
C01 | 8 px | 0 | 5 | 5
C02 | 8 px | 8 | 5 | 5
C03 | 16 px | 0 | 5 | 5
C04 | 16 px | 8 | 5 | 5
C05 | 24 px | 0 | 5 | 5
C06 | 24 px | 8 | 5 | 5

3 × 2 condiciones × 5 repeticiones = 30 capturas.
5 fuentes de diámetro nominal 4 px; exposición y ganancia fijadas en D1.

Planificación del DoE. Factores, niveles y cantidades propuestos para el ensayo.

08

Notes: D3 estudiará tres separaciones y dos niveles de ruido añadido, con cinco repeticiones por condición. Cada cuadro contendrá cinco fuentes de igual intensidad. Exposición, ganancia y tamaño se mantendrán fijos. El tamaño nominal inicial será cuatro píxeles de diseño y deberá ser observable en D2. Antes de congelar la matriz se comprobará que los discos del patrón no se solapan nominalmente.

Fuentes y alcance:
Planificación del DoE. Factores, niveles y cantidades propuestos para el ensayo.
El tamaño y el perfil se fijarán tras D1–D2. Si D2 exige otro tamaño, se redefinirán las separaciones antes de la ejecución para evitar solapamiento de los discos. σRGB no equivale al ruido Y del sensor. Se guardarán semilla, clipping y estadística efectiva del fondo del patrón.

## Slide 9

DoE · Cantidad de capturas planificada

Bloque | Cálculo | Capturas
D1 | 3 × 2 × 5 | 30
D2 | 3 × 2 × 5 | 30
D3 | 3 × 2 × 5 | 30
Subtotal matrices | 18 condiciones × 5 | 90
Piloto | 5 capturas | 5
Niveles digitales Y | 5 niveles × 3 | 15
Mapa geométrico | 9 posiciones × 3 | 27
Confirmación D2 | 2 posiciones × 5 | 10
Total DoE | 90 + 57 | 147
LAP reservado | 4 lotes × 5 | 20
Total planificado | 147 + 20 | 167

Las 20 capturas del LAP serán nuevas y se conservarán separadas del ajuste del DoE.

Planificación del DoE. Factores, niveles y cantidades propuestos para el ensayo.

09

Notes: Las matrices de D1, D2 y D3 programan treinta capturas cada una, noventa en total. La preparación contempla cinco fotos de piloto, quince referencias de niveles digitales, veintisiete para geometría y diez de confirmación de D2. Esto suma ciento cuarenta y siete capturas del DoE. El LAP tendrá veinte nuevas, por lo que el total planificado será ciento sesenta y siete. Los reintentos se registrarán aparte. Las referencias de niveles digitales usarán RGB 0, 64, 128, 192 y 255 con tres capturas por nivel.

Fuentes y alcance:
Planificación del DoE. Factores, niveles y cantidades propuestos para el ensayo.

## Slide 10

DoE · Procedimiento de adquisición

Paso | Acción planificada
1 · Preparación | Fijar distancia, foco, pose, pantalla, formato y versiones
2 · Programación | Congelar niveles y sortear condiciones dentro de 5 bloques
3 · Estabilización | Aplicar parámetros y esperar patrón y sensor estables
4 · Adquisición | Solicitar un cuadro y verificar cabecera, longitud y checksum
5 · Registro | Guardar RAW, PNG, condición, bloque, tiempo y parámetros
6 · Incidencias | Conservar fallos y añadir reintentos con un ID distinto

Planificación del DoE. Factores, niveles y cantidades propuestos para el ensayo.

10

Notes: Primero se fijarán el montaje y las condiciones de pantalla y se versionarán los patrones. Después se ejecutará la preparación y se congelará la matriz. Las condiciones de cada etapa se programarán en cinco bloques con orden aleatorio registrado. Se esperará la estabilización después de cada cambio, se capturará un cuadro completo y se guardarán imagen y metadatos. Al finalizar cada bloque se revisará la integridad y se registrarán las incidencias.

Fuentes y alcance:
Planificación del DoE. Factores, niveles y cantidades propuestos para el ensayo.
Cada bloque contiene seis condiciones con una captura por condición. Son repeticiones temporales del mismo montaje. La semilla de orden y el tiempo de estabilización elegido quedarán en el registro. No se confundirá el tiempo de transferencia UART con latencia del procesamiento operativo.

## Slide 11

DoE · Análisis previsto y entregables

Etapa | Análisis previsto | Entregable
D1 | Efectos de E, G e interacción sobre contraste y picos | Perfil candidato y gráficas comparativas
D2 | Efectos de diámetro y posición sobre FWHM y centroide | Tamaño útil, mapa y dispersión por condición
D3 | Efectos de separación y ruido sobre detección y fusión | Dominio de separación y matriz de errores

Se informarán media, dispersión, número de cuadros y denominadores de cada tasa.
Antes del LAP se fijarán perfil, tamaño, umbral y condiciones de comprobación.

Planificación del DoE. Factores, niveles y cantidades propuestos para el ensayo.

11

Notes: El análisis comparará respuestas entre niveles y entre bloques. Para D1 se estudiarán contraste, saturación y visibilidad, incluyendo la interacción entre exposición y ganancia. Para D2 se compararán FWHM, centroide, residuo geométrico y dispersión por tamaño y posición. Para D3 se informarán fuentes correctas, fusiones, omisiones y falsas por separación y ruido. La salida será una configuración candidata y su dominio de uso, que deberán comprobarse en el LAP.

Fuentes y alcance:
Planificación del DoE. Factores, niveles y cantidades propuestos para el ensayo.

## Slide 12

LAP · Alcance y fundamento

Objeto y condiciones

Se comprobarán captura QVGA,
centroide PC y separación.
Perfil y umbral congelados.
Montaje y patrones identificados.
Capturas nuevas reservadas.
D4–D5: etapas posteriores.

Referencias del método

Schulz et al. (2021)
Universal Verification Platform and Star Simulator for Fast Star Tracker Design
Sun, Xing y You (2013)
Optical System Error Analysis and Calibration Method of High-Accuracy Star Trackers
Lou et al. (2026)
A Multi-Strategy Adaptive Error Modeling and Compensation Method for Star Point Centroid Extraction

Planificación del LAP. Criterios y evidencias por comprobar antes de emitir una decisión.

12

Notes: La segunda parte planifica cómo se decidirá la aceptación. El LAP definirá requisitos de captura, referencia y centroide en PC y separación del campo. Los parámetros se mantendrán fijos y se utilizarán capturas nuevas, reservadas frente al ajuste del DoE. Las referencias respaldan el uso de escenas controladas, geometría y métricas de error. Los límites concretos serán criterios propuestos del banco y deberán fijarse antes de esta ejecución.

Fuentes y alcance:
Planificación del LAP. Criterios y evidencias por comprobar antes de emitir una decisión.

Schulz et al. (2021). Universal Verification Platform and Star Simulator for Fast Star Tracker Design. https://doi.org/10.3390/s21030907
Sun, Xing y You (2013). Optical System Error Analysis and Calibration Method of High-Accuracy Star Trackers. https://doi.org/10.3390/s130404598
Lou et al. (2026). A Multi-Strategy Adaptive Error Modeling and Compensation Method for Star Point Centroid Extraction. https://doi.org/10.5194/isprs-archives-XLIX-B1-2026-279-2026

## Slide 13

LAP · Requisitos y métodos de verificación

Ensayo | Requisito por comprobar | Método previsto
L01 · Imagen | Cuadro completo e integridad de datos | Dimensiones, checksum y casos corruptos
L02 · Captura | Cinco fuentes distinguibles y sin saturación | Componentes, picos Y y contraste de cada fuente
L03 · Centroide PC | Referencia local y posición repetible | Puntos reservados, RMS de reproyección y σ radial
L04 · Separación | Cinco fuentes distintas en el campo | Asociación geométrica y conteo de errores

D4, D5 y la aceptación del centroide operativo FPGA no forman parte de este LAP.

Planificación del LAP. Criterios y evidencias por comprobar antes de emitir una decisión.

13

Notes: Se definirán cuatro requisitos dentro del alcance. L01 conservará tamaño, orden e integridad de los datos y rechazará paquetes erróneos. L02 comprobará que el perfil elegido represente las cinco fuentes sin saturarlas. L03 exigirá una referencia geométrica comprobada y un centroide repetible en PC. L04 comprobará que se distingan las cinco fuentes del campo en los casos de ruido programados. Cada requisito tendrá un método y una evidencia prevista.

Fuentes y alcance:
Planificación del LAP. Criterios y evidencias por comprobar antes de emitir una decisión.
Trazabilidad: RS-03 para rechazo de cuadros erróneos, RB-03 para referencia geométrica, RB-04/RB-05 para patrones y conjunto reservado, RD-02 para identificación de cada evidencia. La meta de centroide del sistema no se declarará cumplida con un cálculo en PC.

## Slide 14

LAP · Criterios de aceptación propuestos

Ensayo | Criterio que se aplicará
L01 · Imagen | 320×240, 76 800 Y y checksum correcto. Truncados y checksum erróneo: rechazo.
L02 · Captura | 5 fuentes por cuadro, pico <250 DN y contraste/ruido ≥6.
L03 · Centroide PC | RMS de referencia reservada ≤0,2 px y σ radial por posición ≤0,5 px.
L04 · Separación | 25/25 fuentes esperadas por caso: 0 fusiones, 0 omisiones y 0 falsas.

Los criterios se congelarán antes de adquirir el conjunto reservado del LAP.

Planificación del LAP. Criterios y evidencias por comprobar antes de emitir una decisión.

14

Notes: Los criterios se fijarán antes del LAP. L01 verificará el contrato de imagen y que los casos erróneos no se acepten. L02 comprobará cinco fuentes con pico inferior a doscientos cincuenta y contraste relativo mínimo de seis. L03 utilizará un RMS reservado de referencia de hasta 0,2 píxeles y una dispersión radial del centroide de hasta 0,5 píxeles. L04 exigirá cinco fuentes correctas en cada uno de los cinco cuadros de cada caso. Estas son metas del plan, no medidas obtenidas.

Fuentes y alcance:
Planificación del LAP. Criterios y evidencias por comprobar antes de emitir una decisión.
L01 empleará además dos casos digitales de rechazo (truncado y checksum modificado), que no son capturas físicas adicionales. En L02 el ruido robusto se estimará en fondo y su fórmula se fijará antes de ejecutar. En L03 0,2 px es el criterio inicial propuesto de referencia local RB-03, sujeto a revisión previa. No es una comprobación de exactitud absoluta ni de salida FPGA. En L04 cada caso tiene 5 capturas de 5 fuentes, denominador 25.

## Slide 15

LAP · Muestra y evidencias esperadas

Lote | Escena reservada | σRGB | Capturas
A | 5 fuentes, separación s* | 0 | 5
B | 5 fuentes, misma separación s* | 8 | 5
C | Fuente aislada central | 0 | 5
D | Fuente aislada a +50 px | 0 | 5
Total | Capturas nuevas reservadas | | 20

s*, tamaño, perfil y umbral se fijarán con el DoE.
Evidencias: RAW/PNG, logs de integridad, CSV de medidas y decisión por requisito.

Planificación del LAP. Criterios y evidencias por comprobar antes de emitir una decisión.

15

Notes: El conjunto reservado del LAP tendrá cuatro lotes de cinco capturas: campo de cinco fuentes sin ruido, el mismo campo con ruido ocho, una fuente central y una desplazada cincuenta píxeles. Son veinte capturas nuevas. Las mismas veinte servirán para integridad; el lote A para calidad de captura; C y D para centroide; A y B para separación. Se guardarán originales, logs y un registro con la medición y la regla aplicada.

Fuentes y alcance:
Planificación del LAP. Criterios y evidencias por comprobar antes de emitir una decisión.
Los lotes comparten funciones de verificación sin contar dos veces una captura. L01: A+B+C+D (20). L02: A (5). L03: C+D (10). L04: A+B (10). Los casos corruptos de L01 son pruebas digitales adicionales. El CSV tendrá ID, condición, lote, tiempo, versiones, E/G, tamaño, posición, separación, ruido, métricas, hash y regla de decisión.

## Slide 16

LAP · Decisión y tratamiento de desviaciones

Situación prevista | Tratamiento planificado
Conforme | Todos los criterios aplicables satisfechos y evidencia completa.
No conforme | Registrar criterio incumplido, magnitud, condición y evidencia.
No evaluable | Registrar referencia, control o datos faltantes y programar reposición.
Corrección | Conservar originales, versionar el cambio y repetir el alcance afectado.

Entrega prevista: matriz requisito–método–criterio–evidencia–decisión y registro de desviaciones.

Planificación del LAP. Criterios y evidencias por comprobar antes de emitir una decisión.

16

Notes: La decisión se emitirá únicamente después de comparar las medidas del conjunto reservado con los criterios fijados. Se podrá registrar conformidad, no conformidad o resultado no evaluable. Toda desviación conservará su evidencia y su causa. Si se cambia un parámetro para corregirla, se guardará una nueva configuración y se repetirá el alcance afectado con un nuevo conjunto de comprobación. La documentación cerrará con una matriz de decisiones por requisito.

Fuentes y alcance:
Planificación del LAP. Criterios y evidencias por comprobar antes de emitir una decisión.
Roles previstos: Alexander ejecutará el montaje y registrará las condiciones; el sistema automatizado adquirirá y analizará; el revisor comprobará trazabilidad y criterios. Se conservará cada intento fallido y su repetición con ID distinto. Si la corrección modifica los parámetros seleccionados, se volverá al DoE antes de otro LAP.
