gf5ckszr2d-cell/tesis-star-tracker/pruebas_arty_z7/captura_ov7670_qvga/pc/doe_web/operator.html

# Banco Arty QVGA: captura y separacion

Centroides y medidas en PC. Limite: D3. El PPT se completara con los resultados despues del ensayo.

Abrir patron en el G5. Mueve esa ventana al G5 y activa pantalla completa. Usa este panel en otra pantalla o desde Codex. Si usas una sola pantalla, vuelve al patron despues de confirmar cada pausa.

Detener ensayo

## Condiciones iniciales

Soporte fijo y camara conectada con el cableado QVGA Lente lista para ajustar el enfoque visual HDR, brillo adaptativo y filtros de color desactivados G5 a 2560 x 1440 y patron a pantalla completa Brillo del monitor = 0, fijo durante el ensayo Confirmo que la pantalla del patron es el Samsung G5 Refresco utilizado (Hz) Distancia real lente-centro del panel (mm) Observaciones de luz y montaje Iniciar adquisicion

## Enfoque visual

Evalua el punto a ampliacion fija 2x con vecinos cercanos. Ajusta fisicamente la lente si hace falta. Una nueva vista tarda aproximadamente 7 segundos.

Nueva vista del enfoque Confirmar enfoque y continuar

## Evaluacion visual D1

Selecciona Si o No en cada criterio de las 30 imagenes. Todos los originales se muestran a la misma ampliacion 2x. Los numeros no sustituyen tu juicio visual.

Condicion seleccionada Justificacion y consistencia entre capturas Guardar criterio y continuar D2-D3
