gf5ckszr2d-cell/tesis-star-tracker/pruebas_arty_z7/captura_ov7670_qvga/evidencias/orientacion_20261110/frame_y.png

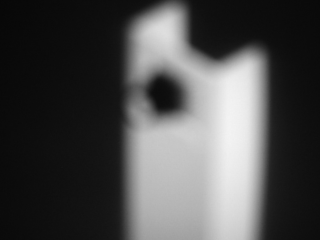
pruebas_arty_z7/captura_ov7670_qvga/evidencias/orientacion_20261110/frame_y.png
