gf5ckszr2d-cell/tesis-star-tracker/pruebas_arty_z7/captura_ov7670_qvga/FIX_010.md

# Correccion y diagnostico del 010 - 21-10-2026

La FSM del hito 1 ya esperaba una sincronizacion VSYNC antes de capturar. Su test
original cubria habilitar la captura en mitad de una linea y descartar esos bytes.
Ese comportamiento se conserva.

Se reprodujo otro caso: HREF activo durante VSYNC, y ambos pasan a cero juntos.
`href_active_prev` conservaba el HREF del blanking y `close_line_if_needed` cerraba
una linea ficticia de cero bytes, incrementando la fila. La validacion de longitud
agregada el 21-10 activaba overflow y terminaba en LED `010`.

Prueba antes: `build/blanking_before.log`, FAIL a 280 ns. Prueba despues:
`build/blanking_after.log`, PASS_CAPTURE_BLANKING a 1560 ns. Esto confirma un fallo
del RTL anterior; por si solo no demuestra que sea la causa de la observacion fisica.

| Antes | Despues |
|---|---|
| HREF del blanking podia contarse como linea | Se limpia `href_active_prev` mientras VSYNC esta activo |
| `010` agrupaba varios errores | ARM informa causa, lineas, min/max de bytes por linea, pixeles y primera linea mala |
| Era necesario pulsar BTN1 para cada prueba | BTN1 sigue funcionando; enviar `c` por COM3 solicita la misma captura con el mismo debounce |
| Sin contador observable desde ARM | Snapshot estable de 64 bits mediante GPIO EMIO interno del PS, sin pines externos ni IP AXI adicional |

YUV422, 160x120, XCLK, BRAM y paquete binario STY1 permanecen iguales.
Tampoco se modifica la captura Nexys. La primera prueba fisica mantuvo los
21 valores de registro originales; la correccion posterior cambia tres de ellos.

Mensaje esperado para una captura completa:

```text
ARM captura: OK lineas=120 bytes_min=320 bytes_max=320 pixeles=19200 primera_linea_mala=ninguna
```

`LINEA_CORTA`, `LINEA_LARGA`, `BYTES_IMPARES`, `FALTAN_LINEAS`, `SOBRAN_LINEAS`,
`CUENTA_PIXELES`, `ORDEN_BRAM` y `OVERFLOW_CAPTURA` distinguen las condiciones.
La primera linea mala usa indice desde cero. Los contadores se saturan a
255 lineas, 4095 bytes por linea y 65535 pixeles; la geometria nominal queda dentro
de estos limites. Los datos se publican al terminar el frame, incluso si se rechaza.

El snapshot cruza hacia los bancos GPIO EMIO 2/3, registros de entrada PS
`0xE000A068`/`0xE000A06C`. Se mantiene estable hasta el siguiente frame/reset;
ARM compara dos lecturas completas para descartar una actualizacion en curso.
GPIO_O[0] produce un pulso interno de 30 ms al recibir `c`; no llega a ningun pin
de camara. BTN1 y este pulso comparten el filtro de 20 ms.

La plataforma Vitis debe usar el nuevo XSA y `ps7_init.tcl` con GPIO EMIO habilitado.
`scripts/load_capture.tcl` utiliza esos archivos. COM3 siempre usa **115200 8N1**;
921600 solo corresponde al enlace interno PL-UART1-ARM.

Las lineas de diagnostico se imprimen entre paquetes binarios. El receptor Python
las muestra sin mezclarlas con el payload. Se corrigio tambien el parser PC para
mostrar la ultima linea de diagnostico aunque no llegue una imagen despues.

Regresiones: `simulate_blanking.tcl`, `simulate_capture_diag.tcl`,
`simulate_diag.tcl` y `simulate.tcl` con dos imagenes completas y HREF en blanking.
`pc/probe_capture.py --trigger` permite registrar una captura real y sus mensajes.

## Causa fisica medida y ventana horizontal

La primera carga real de BIT + ELF corregidos por JTAG produjo:

```text
ARM captura: LINEA_CORTA lineas=120 bytes_min=312 bytes_max=312 pixeles=18720 primera_linea_mala=0
```

Evidencia preservada: `build/physical_before_window/report.json` y `uart.bin`.
Por tanto, el fallo de blanking no explicaba por si solo el 010 real: el sensor
entregaba 156 pixeles por linea, frente a los 160 exigidos. No se rellena BRAM
con ceros ni se relaja la validacion para ocultar esos cuatro pixeles faltantes.

Se cambia exclusivamente la ventana horizontal en la ROM Arty:

| Registro | Antes | Despues |
|---|---|---|
| HSTART 0x17 | 0x11 | 0x17 |
| HSTOP 0x18 | 0x61 | 0x05 |
| HREF 0x32 | 0x80 | 0x92 |

Esto codifica inicio 186 y fin 42, con wrap horizontal de 784, una ventana de
640 antes de reducir /4. Es la ventana horizontal DIV4 del
[controlador original de Adafruit](https://github.com/adafruit/Adafruit_OV7670/blob/master/src/ov7670.c),
funciones `OV7670_frame_control` y `OV7670_set_size`. Se conserva la ventana
vertical ya medida en 120 lineas y la configuracion de escalado QQVGA de la
[guia OmniVision, tabla 2-2](https://www.haoyuelectronics.com/Attachment/OV7670%20%2B%20AL422B%28FIFO%29%20Camera%20Module%28V2.0%29/OV7670%20Implementation%20Guide%20%28V1.0%29.pdf).
El modelo SCCB del TB espera los tres valores nuevos. La geometria sintetica
del TB no sustituye la comprobacion de HREF/bytes reales por el monitor.

Los resultados de esta segunda carga y prueba se agregan abajo.

Implementacion de la ventana corregida: `PASS_BUILD_DIAGNOSTICO`, WNS +3.458 ns,
WHS +0.046 ns y TNS/THS cero. CDC: cero warnings/critical; permanecen las
recomendaciones DSP DPOP-1/2 y los avisos de metodologia E/S ya documentados.
No se han sustituido por supuestos las medidas electricas externas pendientes.
Vitis recompila la plataforma y el ARM; el verificador comprueba identidad por
SHA-256 entre BIT, BIT incluido en XSA, XSA de plataforma, ELF y copias de Run.

## Resultado fisico final

Se cargaron BIT y ELF finales mediante `scripts/load_capture.tcl`. El receptor
`pc/probe_capture.py --trigger --frames 2` obtuvo dos capturas consecutivas,
sin reset entre ellas, con esta medicion en ambas:

```text
ARM captura: OK lineas=120 bytes_min=320 bytes_max=320 pixeles=19200 primera_linea_mala=ninguna
OK imagen 19200 checksum; esperando BTN1
```

Evidencia: `build/load_capture.log`, `build/physical_console.log`,
`build/physical_fix010/report.json`, `uart.bin` y dos pares PNG/RAW:
`captura_20261021_025310_691499` y `captura_20261021_025312_773939`.
El reporte termina con result=0, dos imagenes y cero errores del receptor.
Las dos imagenes se validaron como 160x120 y su checksum STY1 fue correcto.
La escena recibida se ve oscura/desenfocada; esta prueba acredita geometria,
integridad de paquete y repeticion de captura, no enfoque ni calibracion optica.

El 010 observado queda resuelto en esta prueba real por el ajuste horizontal.
La correccion de HREF durante VSYNC se mantiene con su regresion separada.
El hito 1 ya esperaba VSYNC, pero su almacenamiento anterior aceptaba frame_done
sin exigir que se hubieran escrito los 19200 pixeles: por eso una salida visible
anterior no acredita que cada linea del sensor tuviera los 320 bytes esperados.

XSim final: `build/simulation_window_console.log`, PASS_CAPTURA_UART a
27.243492117 ms, incluyendo los tres registros nuevos y dos tramas completas.
Los seis tests del receptor PC tambien pasan. COM3 queda cerrado y libre al
terminar la prueba; en Vitis usar 115200 8N1. La placa queda ejecutando el ARM
final; BTN1 conserva la solicitud de nuevas capturas.
