gf5ckszr2d-cell/tesis-star-tracker/Inventor/Mecanismo_3GDL/Original/PLANITOS.pdf

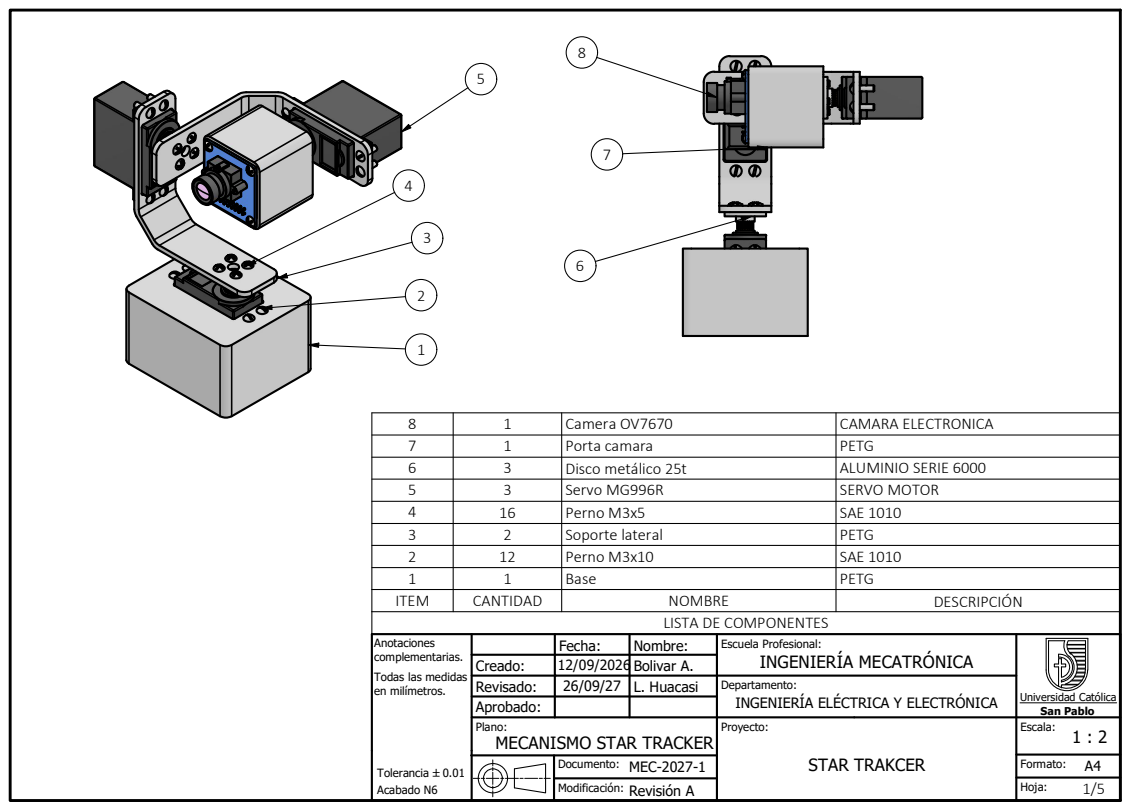
[picture p28: page 1]
Bolivar A.; Escuela Profesional: INGENIERÍA MECATRÓNICA; Universidad Católica San Pablo; Tolerancia `0.01; Acabado N6

8 | 1 | Camera OV7670 | CAMARA ELECTRONICA
7 | 1 | Porta camara | PETG
6 | 3 | Disco metálico 25t | ALUMINIO SERIE 6000
5 | 3 | Servo MG996R | SERVO MOTOR
4 | 16 | Perno M3x5 | SAE 1010
3 | 2 | Soporte lateral | PETG
2 | 12 | Perno M3x10 | SAE 1010
1 | 1 | Base | PETG
ITEM | CANTIDAD | NOMBRE | DESCRIPCIÓN

LISTA DE COMPONENTES

complementarias.
Todas las medidas
en milímetros.

Revisado: | 26/09/27 | L. Huacasi | Departamento: INGENIERÍA ELÉCTRICA Y ELECTRÓNICA
Aprobado:

Plano: MECANISMO STAR TRACKER | Proyecto: STAR TRAKCER | Escala: 1 : 2

Documento: MEC-2027-1 | | Formato: A4

Modificación: Revisión A | | Hoja:

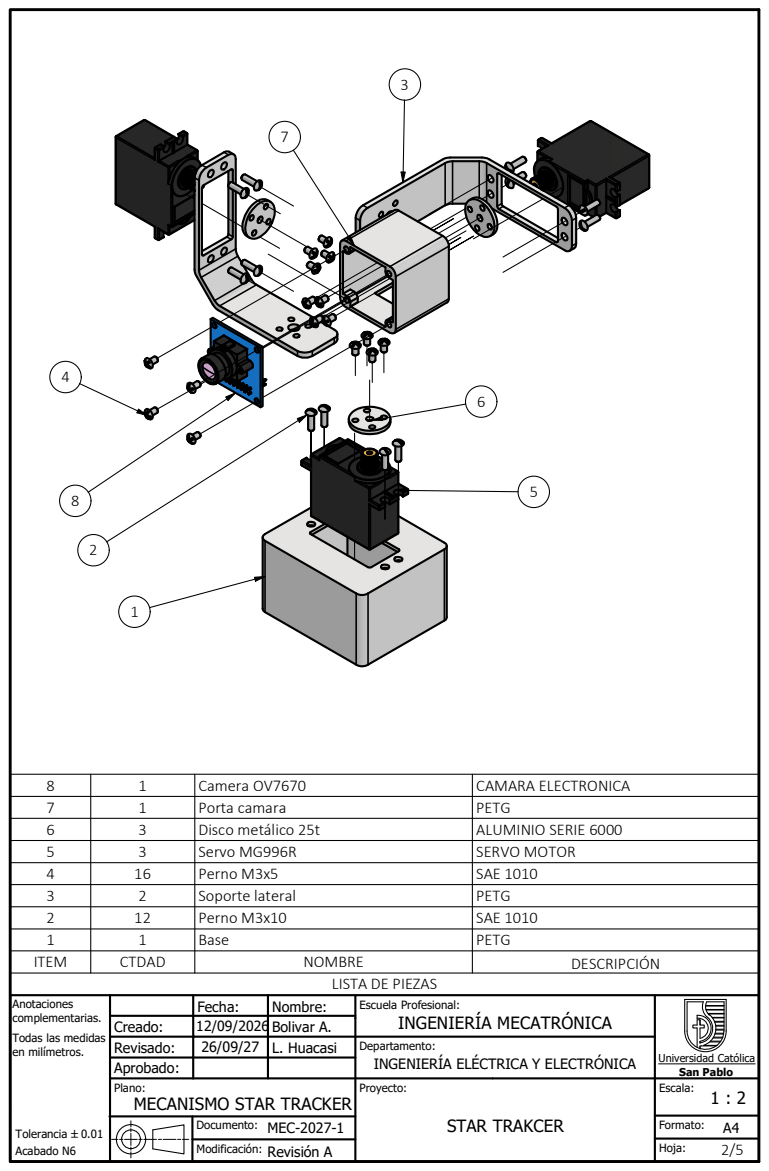
[picture p29: page 2]
Bolivar A.; Escuela Profesional: INGENIERÍA MECATRÓNICA; Universidad Católica San Pablo

8 | 1 | Camera OV7670 | CAMARA ELECTRONICA
7 | 1 | Porta camara | PETG
6 | 3 | Disco metálico 25t | ALUMINIO SERIE 6000
5 | 3 | Servo MG996R | SERVO MOTOR
4 | 16 | Perno M3x5 | SAE 1010
3 | 2 | Soporte lateral | PETG
2 | 12 | Perno M3x10 | SAE 1010
1 | 1 | Base | PETG
ITEM | CTDAD | NOMBRE | DESCRIPCIÓN

LISTA DE PIEZAS

complementarias.
Todas las medidas
en milímetros.

Revisado: | 26/09/27 | L. Huacasi | Departamento: INGENIERÍA ELÉCTRICA Y ELECTRÓNICA
Aprobado:

Plano: MECANISMO STAR TRACKER | Proyecto: STAR TRAKCER | Escala: 1 : 2

Documento: MEC-2027-1 | | Formato: A4

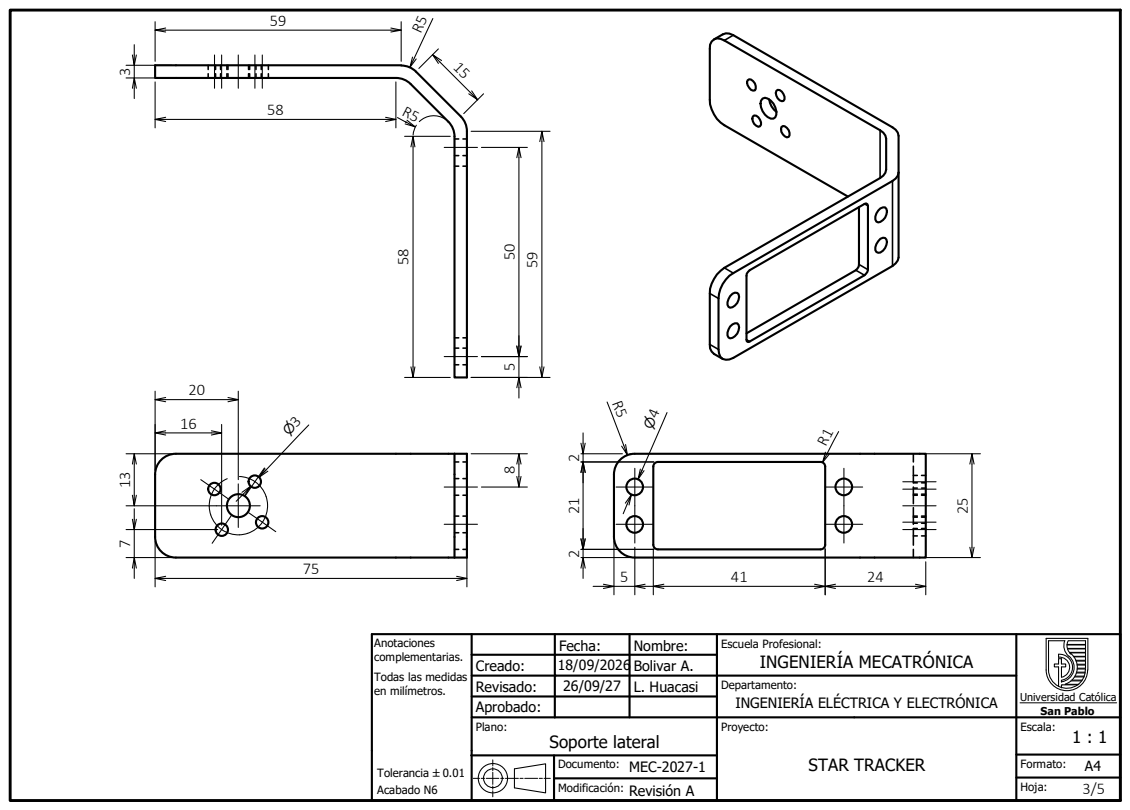
[picture p30: page 3]
Bolivar A.; Escuela Profesional: INGENIERÍA MECATRÓNICA; Universidad Católica San Pablo

complementarias.
Todas las medidas
en milímetros.

Revisado: | 26/09/27 | L. Huacasi | Departamento: INGENIERÍA ELÉCTRICA Y ELECTRÓNICA
Aprobado:

Plano: Soporte lateral | Proyecto: STAR TRACKER | Escala: 1 : 1

Documento: MEC-2027-1 | | Formato: A4

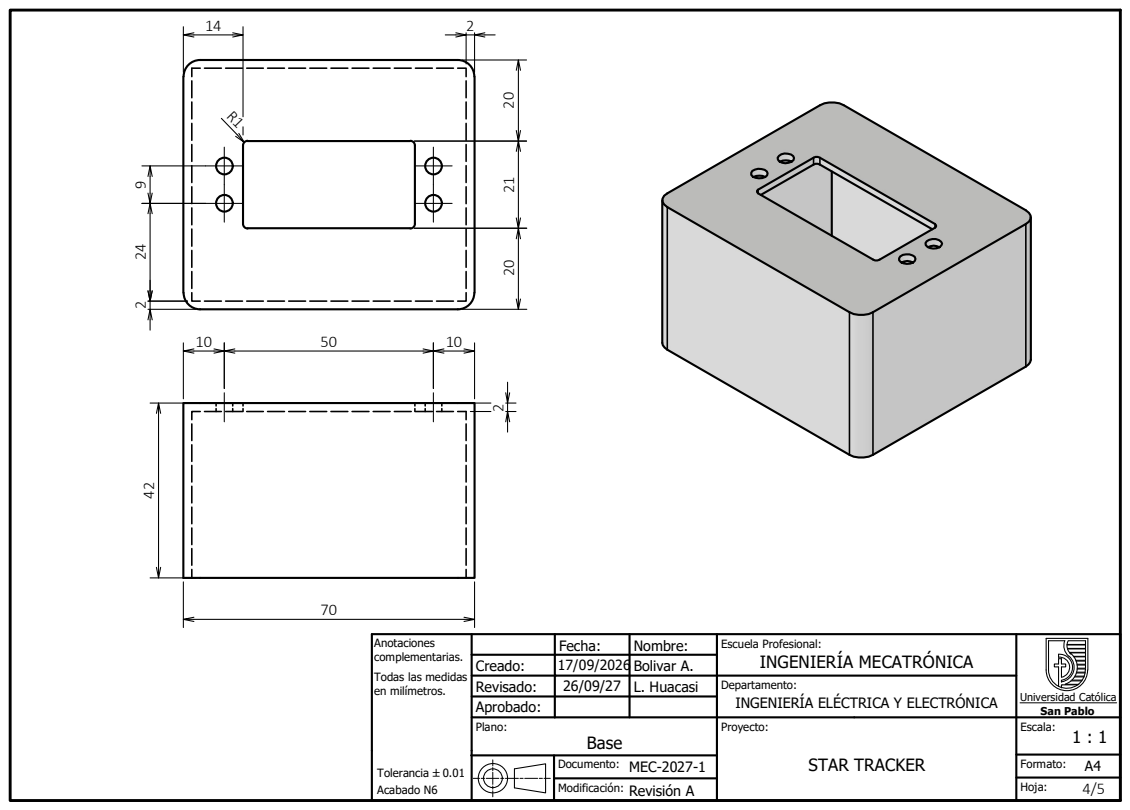
[picture p31: page 4]
Bolivar A.; Escuela Profesional: INGENIERÍA MECATRÓNICA; Universidad Católica San Pablo

complementarias.
Todas las medidas
en milímetros.

Revisado: | 26/09/27 | L. Huacasi | Departamento: INGENIERÍA ELÉCTRICA Y ELECTRÓNICA
Aprobado:

Plano: Base | Proyecto: STAR TRACKER | Escala: 1 : 1

Documento: MEC-2027-1 | | Formato: A4

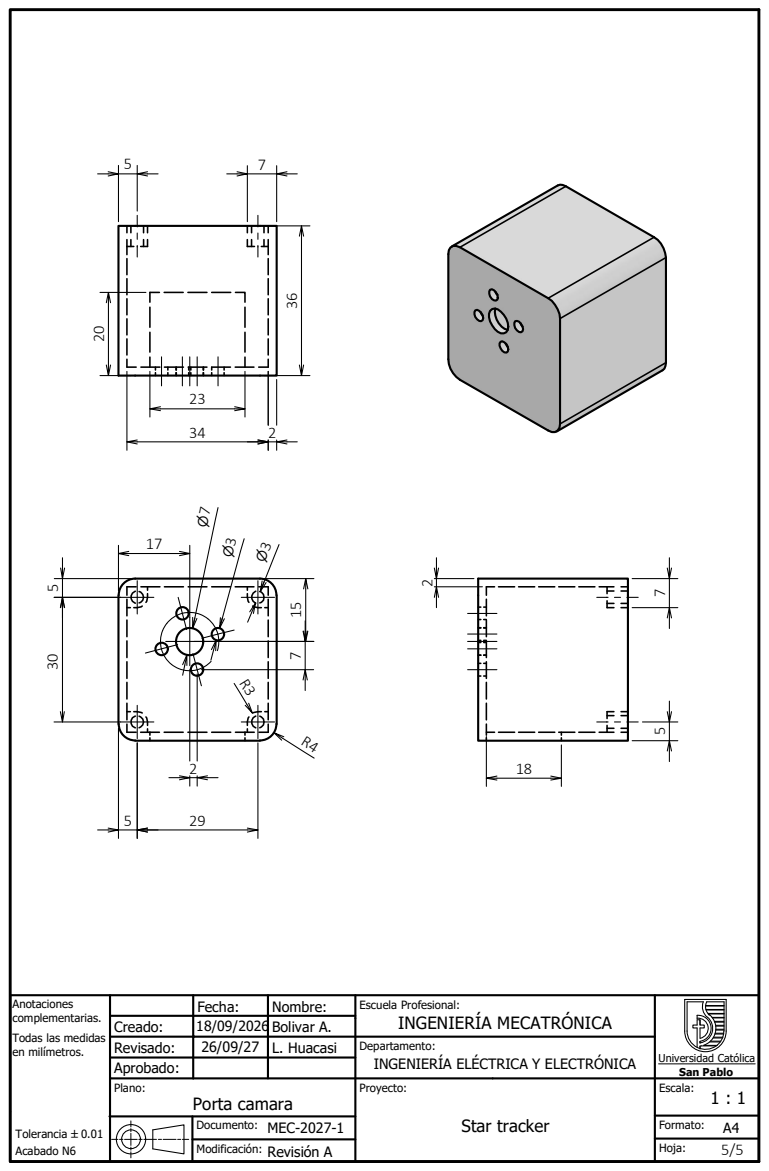
[picture p32: page 5]
Bolivar A.; Escuela Profesional: INGENIERÍA MECATRÓNICA; Universidad Católica San Pablo

complementarias.
Todas las medidas
en milímetros.

Revisado: | 26/09/27 | L. Huacasi | Departamento: INGENIERÍA ELÉCTRICA Y ELECTRÓNICA
Aprobado:

Plano: Porta camara | Proyecto: Star tracker | Escala: 1 : 1

Documento: MEC-2027-1 | | Formato: A4
