gf5ckszr2d-cell/tesis-star-tracker/Inventor/Mecanismo_3GDL/Alineacion_R1_20261113/Control/parametros_para_alineacion.txt

PART=Base_Z.ipt
 PARAM=d0 EXPR=60 mm VALUE=6
 PARAM=d1 EXPR=25 mm VALUE=2.5
 PARAM=d2 EXPR=3 mm VALUE=0.3
 PARAM=d3 EXPR=0.00 gr VALUE=0
 PARAM=d6 EXPR=15 mm VALUE=1.5
 PARAM=d7 EXPR=15 mm VALUE=1.5
 PARAM=d9 EXPR=25 mm VALUE=2.5
 PARAM=d10 EXPR=0.00 gr VALUE=0
 PARAM=d11 EXPR=5 mm VALUE=0.5
 PARAM=d12 EXPR=5 mm VALUE=0.5
 PARAM=d13 EXPR=3 mm VALUE=0.3
 PARAM=d14 EXPR=0.00 gr VALUE=0
 PARAM=d15 EXPR=0.5 mm VALUE=0.05
 PARAM=d16 EXPR=4 mm VALUE=0.4
 PARAM=d17 EXPR=3 mm VALUE=0.3
 PARAM=d18 EXPR=0.00 gr VALUE=0
 FEATURE=Extrusión1 TYPE=83910656 HEALTH=11778
 FEATURE=Extrusión2 TYPE=83910656 HEALTH=11778
 FEATURE=Empalme1 TYPE=83911680 HEALTH=11778
 FEATURE=Empalme2 TYPE=83911680 HEALTH=11778
 FEATURE=Extrusión3 TYPE=83910656 HEALTH=11778
 FEATURE=Extrusión4 TYPE=83910656 HEALTH=11778
 SKETCH=Boceto1 HEALTH=11778
 DIM=83905792 PARAM=d0 EXPR=60 mm
 DIM=83905792 PARAM=d1 EXPR=25 mm
 SKETCH=Boceto2 HEALTH=11778
 DIM=83905792 PARAM=d6 EXPR=15 mm
 DIM=83905792 PARAM=d7 EXPR=15 mm
 SKETCH=Boceto3 HEALTH=11778
 CIRCLE=-10,-2.22044604925E-14,3 R_MM=2.75
 CIRCLE=-10,-2.22044604925E-14,3 R_MM=10
 CIRCLE=-4.24844085789,-3.98993326196,3 R_MM=1.5
 CIRCLE=-13.989933262,-5.75155914211,3 R_MM=1.5
 CIRCLE=-15.7515591421,3.98993326195,3 R_MM=1.5
 CIRCLE=-6.01006673805,5.75155914211,3 R_MM=1.5
 SKETCH=Boceto4 HEALTH=11778
 CIRCLE=42,4.5,70 R_MM=2
 CIRCLE=42,-4.5,70 R_MM=2
 CIRCLE=42,4.5,19.7 R_MM=2
 CIRCLE=42,-4.5,19.7 R_MM=2
 DIM=83907072 PARAM=d15 EXPR=0.5 mm
 DIM=83906560 PARAM=d16 EXPR=4 mm
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
 CYL_R_MM=4.5 CENTER=0,0,0 AX=0,0,1
 CYL_R_MM=1.75 CENTER=0,0,0 AX=0,0,1
 CYL_R_MM=1.5 CENTER=-2.22044604925E-15,7,0 AX=0,0,1
 CYL_R_MM=1.5 CENTER=7,4.4408920985E-15,0 AX=0,0,1
 CYL_R_MM=1.5 CENTER=0,-7,0 AX=0,0,1
 CYL_R_MM=1.5 CENTER=-7,0,0 AX=0,0,1
 CYL_R_MM=10 CENTER=0,0,0 AX=0,0,1
