gf5ckszr2d-cell/tesis-star-tracker/pruebas_arty_z7/captura_ov7670_qvga/rtl/i2c_master.vhd

library ieee;
use ieee.std_logic_1164.all;
use ieee.numeric_std.all;

entity i2c_master is
  generic (
    CLK_FREQ_HZ : integer := 100000000;
    I2C_SCL_HZ  : integer := 100000
  );
  port (
    clk : in std_logic;
    rst : in std_logic;

    start      : in std_logic;
    slave_addr : in std_logic_vector(6 downto 0);
    rw         : in std_logic;

    tx_byte0 : in std_logic_vector(7 downto 0);
    tx_byte1 : in std_logic_vector(7 downto 0);
    tx_count : in unsigned(1 downto 0);

    rx_data : out std_logic_vector(7 downto 0);

    sda_i : in  std_logic;
    sda_t : out std_logic;
    SCL   : out std_logic;
    
    busy      : out std_logic;
    done      : out std_logic;
    ack_error : out std_logic
  );
end entity;

architecture rtl of i2c_master is

  -- Four phases: lower SCL, establish SDA, raise SCL, sample/hold.
  constant TICK_DIVIDER : integer := CLK_FREQ_HZ / (I2C_SCL_HZ * 4);
  constant DIV_MAX      : integer := TICK_DIVIDER - 1;

  type state_t is (
    IDLE,
    START_SDA_LOW,
    START_HOLD,
    START_SCL_LOW,
    SEND_BIT_LOW,
    PREPARE_DATA_LOW,
    SEND_BIT_HIGH,
    SEND_BIT_HOLD,
    ACK_LOW,
    ACK_RELEASE,
    ACK_HIGH,
    ACK_SAMPLE,
    READ_BIT_LOW,
    READ_BIT_SETUP,
    READ_BIT_HIGH,
    READ_BIT_SAMPLE,
    READ_NACK_LOW,
    READ_NACK_SETUP,
    READ_NACK_HIGH,
    READ_NACK_HOLD,
    STOP_SCL_LOW,
    STOP_SDA_LOW,
    STOP_SCL_HIGH,
    STOP_HOLD,
    STOP_RELEASE,
    WAIT_START_RELEASE
  );

  type phase_t is (
    PHASE_ADDR,
    PHASE_TX0,
    PHASE_TX1,
    PHASE_READ
  );

  signal state : state_t := IDLE;
  signal phase : phase_t := PHASE_ADDR;

  signal tick_counter : integer range 0 to DIV_MAX := 0;

  signal scl_reg : std_logic := '1';
  signal sda_drive_low : std_logic := '0';

  signal busy_reg      : std_logic := '0';
  signal done_reg      : std_logic := '0';
  signal ack_error_reg : std_logic := '0';

  signal rw_reg       : std_logic := '0';
  signal tx_count_reg : unsigned(1 downto 0) := (others => '0');

  signal shift_reg : std_logic_vector(7 downto 0) := (others => '0');
  signal rx_reg    : std_logic_vector(7 downto 0) := (others => '0');

  signal bit_index : integer range 0 to 7 := 7;
  signal sda_meta, sda_sync : std_logic := '1';
  attribute ASYNC_REG : string;
  attribute ASYNC_REG of sda_meta, sda_sync : signal is "TRUE";

begin
  process(clk)
  begin
    if rising_edge(clk) then
      if rst = '1' then sda_meta <= '1'; sda_sync <= '1';
      else sda_meta <= to_x01(sda_i); sda_sync <= sda_meta; end if;
    end if;
  end process;

  SCL <= scl_reg;

  sda_t <= not sda_drive_low;

  busy      <= busy_reg;
  done      <= done_reg;
  ack_error <= ack_error_reg;
  rx_data   <= rx_reg;

  process(clk)
    variable tick_now : std_logic;
  begin
    if rising_edge(clk) then

      if rst = '1' then

        state <= IDLE;
        phase <= PHASE_ADDR;

        tick_counter <= 0;

        scl_reg       <= '1';
        sda_drive_low <= '0';

        busy_reg      <= '0';
        done_reg      <= '0';
        ack_error_reg <= '0';

        rw_reg       <= '0';
        tx_count_reg <= (others => '0');

        shift_reg <= (others => '0');
        rx_reg    <= (others => '0');

        bit_index <= 7;

      else

        done_reg <= '0';
        tick_now := '0';

        if tick_counter = DIV_MAX then
          tick_counter <= 0;
          tick_now := '1';
        else
          tick_counter <= tick_counter + 1;
        end if;

        if state = IDLE and start = '1' then

          scl_reg       <= '1';
          sda_drive_low <= '0';

          busy_reg      <= '1';
          ack_error_reg <= '0';

          rw_reg       <= rw;
          tx_count_reg <= tx_count;

          shift_reg <= slave_addr & rw;
          bit_index <= 7;
          phase     <= PHASE_ADDR;

          state <= START_SDA_LOW;

        elsif state = WAIT_START_RELEASE and start = '0' then

          scl_reg       <= '1';
          sda_drive_low <= '0';
          busy_reg      <= '0';

          state <= IDLE;

        elsif tick_now = '1' then

          case state is

            when IDLE =>

              scl_reg       <= '1';
              sda_drive_low <= '0';
              busy_reg      <= '0';

              state <= IDLE;

            when START_SDA_LOW =>

              scl_reg       <= '1';
              sda_drive_low <= '1';
              state         <= START_HOLD;

            when START_HOLD =>
              state <= START_SCL_LOW;

            when START_SCL_LOW =>

              scl_reg       <= '0';
              sda_drive_low <= '1';
              state         <= PREPARE_DATA_LOW;

            when SEND_BIT_LOW =>
              scl_reg <= '0';
              state <= PREPARE_DATA_LOW;

            when PREPARE_DATA_LOW =>

              scl_reg <= '0';

              if shift_reg(bit_index) = '0' then
                sda_drive_low <= '1';
              else
                sda_drive_low <= '0';
              end if;

              state <= SEND_BIT_HIGH;

            when SEND_BIT_HIGH =>

              scl_reg <= '1';
              state <= SEND_BIT_HOLD;

            when SEND_BIT_HOLD =>

              if bit_index = 0 then
                state <= ACK_LOW;
              else
                bit_index <= bit_index - 1;
                state     <= SEND_BIT_LOW;
              end if;

            when ACK_LOW =>

              scl_reg       <= '0';
              state         <= ACK_RELEASE;

            when ACK_RELEASE =>
              sda_drive_low <= '0';
              state         <= ACK_HIGH;

            when ACK_HIGH =>

              scl_reg <= '1';
              state <= ACK_SAMPLE;

            when ACK_SAMPLE =>

              if sda_sync /= '0' then

                ack_error_reg <= '1';
                state         <= STOP_SCL_LOW;

              else

                case phase is

                  when PHASE_ADDR =>

                    if rw_reg = '1' then

                      phase     <= PHASE_READ;
                      bit_index <= 7;
                      state     <= READ_BIT_LOW;

                    else

                      if tx_count_reg = to_unsigned(1, 2) or
                         tx_count_reg = to_unsigned(2, 2) then

                        shift_reg <= tx_byte0;
                        bit_index <= 7;
                        phase     <= PHASE_TX0;
                        state     <= SEND_BIT_LOW;

                      else

                        ack_error_reg <= '1';
                        state         <= STOP_SCL_LOW;

                      end if;
                    end if;

                  when PHASE_TX0 =>

                    if tx_count_reg = to_unsigned(2, 2) then
                      shift_reg <= tx_byte1;
                      bit_index <= 7;
                      phase     <= PHASE_TX1;
                      state     <= SEND_BIT_LOW;
                    else
                      state <= STOP_SCL_LOW;
                    end if;

                  when PHASE_TX1 =>

                    state <= STOP_SCL_LOW;

                  when others =>

                    state <= STOP_SCL_LOW;

                end case;
              end if;

            when READ_BIT_LOW =>

              scl_reg       <= '0';
              sda_drive_low <= '0';
              state         <= READ_BIT_SETUP;

            when READ_BIT_SETUP =>
              state         <= READ_BIT_HIGH;

            when READ_BIT_HIGH =>

              scl_reg           <= '1';
              state <= READ_BIT_SAMPLE;

            when READ_BIT_SAMPLE =>
              rx_reg(bit_index) <= sda_sync;

              if bit_index = 0 then
                state <= READ_NACK_LOW;
              else
                bit_index <= bit_index - 1;
                state     <= READ_BIT_LOW;
              end if;

            when READ_NACK_LOW =>

              scl_reg       <= '0';
              sda_drive_low <= '0';
              state         <= READ_NACK_SETUP;

            when READ_NACK_SETUP =>
              state         <= READ_NACK_HIGH;

            when READ_NACK_HIGH =>

              scl_reg       <= '1';
              sda_drive_low <= '0';
              state         <= READ_NACK_HOLD;

            when READ_NACK_HOLD =>
              state <= STOP_SCL_LOW;

            when STOP_SCL_LOW =>

              scl_reg <= '0';
              state   <= STOP_SDA_LOW;

            when STOP_SDA_LOW =>

              scl_reg       <= '0';
              sda_drive_low <= '1';
              state         <= STOP_SCL_HIGH;

            when STOP_SCL_HIGH =>

              scl_reg       <= '1';
              sda_drive_low <= '1';
              state         <= STOP_HOLD;

            when STOP_HOLD =>
              state <= STOP_RELEASE;

            when STOP_RELEASE =>

              scl_reg       <= '1';
              sda_drive_low <= '0';

              busy_reg <= '0';
              done_reg <= '1';

              state <= WAIT_START_RELEASE;

            when WAIT_START_RELEASE =>

              scl_reg       <= '1';
              sda_drive_low <= '0';
              busy_reg      <= '0';

              if start = '0' then
                state <= IDLE;
              else
                state <= WAIT_START_RELEASE;
              end if;

            when others =>

              state <= IDLE;

          end case;

        end if;

      end if;

    end if;
  end process;

end architecture;
