gf5ckszr2d-cell/tesis-star-tracker/(commit log)

2026-05-14 limpiar FSM I2C y renombrar estado de preparación
2026-05-14 limpiar FSM I2C y renombrar estado de preparación, ahora si
2026-05-14 limpiar FSM I2C y renombrar estado de preparación, ahora si1
2026-05-14 Testbench de i2c_master añadido
2026-05-15 Crear ov7670_manual_wr_rd.vhd
    Módulo para configurar cámara manualmente añadido
2026-05-18 actualizacion codigo de config camara
2026-05-18 actualizacion de nombres de estado de i2c_master
2026-05-22 Actualizar ov7670_manual_wr_rd.vhd
    Actualización de nombre de clock para este módulo
2026-05-22 i2c con funcion de tick y se añadio el modulo de top:star_tracker_top
2026-05-26 actualizacion de manual y tb_i2c, agregue tb de manual y de tb_star_tracker_top
2026-05-26 ahora si actualice el tb_i2c
2026-06-02 Add OV7670 frame capture and UART dump
2026-06-02 Validate OV7670 capture through UART
2026-06-03 Agrega contexto de traspaso y simulacion XSim de I2C
2026-06-03 Agrega ondas listas para simulaciones I2C e init OV7670
2026-06-03 Agrega diagrama FSM de init config OV7670
2026-06-05 Agrega top de prueba I2C e init config con proyecto Vivado
2026-06-09 Prepara top global para prueba en placa
2026-06-09 Prepara bitstreams y actualiza manual de placa
2026-06-09 Ordena pines de camara y regenera bitstreams
2026-06-10 agrego para artyz7
2026-06-10 actualiza cableado y bitstream para arty z7
2026-06-10 agregar rececpion de fram
2026-06-16 hito 1 captura de imagen exitosa
2026-06-16 calibracion de camara
2026-09-11 corrige riesgos de reloj y CDC en Nexys A7
2026-09-12 integra lista de estrellas post-centroides
2026-11-10 feat(arty): prepara banco automatizado DoE hasta separacion
    Agrega control SCCB por EMIO, congelacion y lectura de perfiles, patrones G5 nativos, calibracion RGB-Y y adquisicion D1-D3. Registra el criterio visual humano y analiza centroides en PC con evidencia RAW/PNG, registros, JSON/CSV e informe. La revision fisica y FAT del detector FPGA quedan pendientes.
    Verificado con XSim global, puente SCCB, maestro e integracion completa; 17 pruebas Python y navegador. Vivado genero BIT/XSA con WNS 2.727 ns y WHS 0.043 ns. Vitis compilo ARM y se comprobaron hashes de entrega. Se conservan los 20 avisos de retardos externos pendientes.
2026-11-13 cad: incorporar gimbal 3GDL y revision para banco de pruebas
2026-11-13 cad: centrar ejes y lente del gimbal R1 con evidencia visual
2026-11-14 cad: auditar centro optico y recorrido del gimbal con 125 posturas
